Alexandr-Filatov/KAMAZ_MCU_PCB/Отчетность/Финальный комплект/МПСТ.76721.687263.02.М - Спецификация на плату управления.pdf

Форм.
Зона
Поз.
Обозначение | Наименование

Кол.
Примеч.

Документация

МПСТ.76721.687263.02.М СБ | Сборочный чертеж | 1 | А3х3

Материалы

1 | Стеклотекстолит

фольгированный

FR4 Tg150 35/35-0,3 | 2
2 | | Стеклоткань
препрег FR4 2116 0,115 | 4
3 | | Стеклоткань
препрег FR4 1080 0,076 | 2
4 | | Защитная паяльная маска
Elpemer SD 2467 SM-LDI | 2

## МПСТ.76721.687263.01.М

Изм | Лист | № докум. | Подп. | Дата
Разраб. | Филатов

### Плата управления

Лит. | Лист | Листов
Пров. | Нестеров | 1

### Московский Политех

Н.контр. | Саяхов
Утв. | Келлер
