Alexandr-Filatov/KAMAZ_MCU_PCB/Отчетность/Финальный комплект/МПСТ.76721.758764.02.М - Спецификация на узел управления.pdf

Форм.
Зона
Поз.
Обозначение | Наименование

Кол.
Примеч.

Документация

А3 | МПСТ.76721.758764.02.М СБ | Сборочный чертеж
А4 | МПСТ.76721.758764.02.М Э3 | Схема электрическая

принципиальная

А4 | МПСТ.76721.758764.02.М ПЭ3 | Перечень элементов

Сборочные единицы

А4 | 1 | МПСТ.76721.687263.02.М | Плата силовая | 1

Прочие изделия

2 | Конденсаторы

GRM188R61E106M-25В-

10 мк-20% | 3
3 | Конденсаторы

GRM188R61E475KE11D-25В-

4,7 мкФ-10% | 3
4 | Конденсаторы

GRM188R71C104KA01D-16В-

100 нФ-10% | 20

## МПСТ.76721.758764.02.М

Изм | Лист | № докум. | Подп. | Дата
Разраб. | Филатов

### Узел управления

Лит. | Лист | Листов
Пров. | Нестеров | 1 | 5
Московский
Политех Н.контр. | Саяхов
Утв. | Келлер

5 | Конденсаторы

GRM1885C1H560J-50В-

56 пФ-5% | 9
6 | Конденсатор

GRM188R61E475KE11D-25В-

4,7 мкФ-10% | 1
7 | Конденсаторы

GRM188R71E105KA12D-25В-

1 мкФ-10% | 9
8 | Конденсаторы

GRM188R61A225K-10В-

2,2 мкФ-10% | 2
9 | Конденсаторы

GRM32ER71H106K-50В-

10 мкФ-10% | 6
10 | Конденсаторы

GRM31CR71E106KA12L-25В-

10 мкФ-10% | 2
11 | | Резисторы
RC0603-0,1-10 кОм-1% | 9
12 | Резисторы

6

## МПСТ.76721.758764.02.М

Лист

Изм | Лист | № докум. | Подп. | Дата

13 | | Резистор
RC0603-0,1-1,3 кОм-1% | 1
14 | | Резисторы
RC0603-0,1-1 кОм-1% | 6
15 | | Резисторы
RC0603-0,1-120 Ом-1% | 5
16 | | Резисторы
RC0603-0,1-0 Ом-1% | 8
17 | | Резисторы
RC0603-0,1-1,5 кОм-1% | 2
18 | | Резистор
RC0805-0,125-120 Ом-1% | 1
19 | | Резистор
RC0603-0,1-13 кОм-1% | 1
20 | | Микросхемы CAN
SIT65HVD232DR | 2
21 | | Драйвера MOSFET
IR2184S | 3
22 | | Компаратор
LMV7239M5 | 1

23 | | Дифференциальный
усилитель INA282AID | 1
24 | | Тактовый генератор
ASEMB-10.000MHZ-LC-T | 1
25 | | Микроконтроллер
APM32F407VGT6 | 1
26 | | Микросхема RS-485
ADM3491ARZ | 1
27 | | DC-DC преобразователь
LM2594HVM-12 | 1
28 | | Операционный усилитель
LMV321IDBVR | 1
29 | | DC-DC преобразователь
LM2594HVM-3.3 | 1
30 | Сегнетоэлектрическое

ОЗУ

FM25W256-GTR | 1
31 | Диоды BAS321 | 8
32 | | Устройство защиты
RS-484 PSM712 | 1

33 | Диод Шоттки MBRA320 | 2
34 | | Устройство защиты
CAN шины PESD2CAN | 2
35 | | Ферритовая бусина
BLM18KG102SH1D | 1
36 | | Разъем PicoBlade
SCT1251WR-2P | 2
37 | Штыри на плату PLD-14 | 1
38 | | Разъем PicoBlade
SCT1251WR-5P | 1
39 | | Разъем PicoBlade
SCT1251WR-6P | 1
40 | Вилка штыревая PLD-20 | 1
41 | | Индуктивность 22мкГн-
20% LQH66SN220M | 1
42 | | Индуктивность 33мкГн-
20% LQH66SN220M | 1
Изм | Лист | №докум. | Подп. | Дата
