Alexandr-Filatov/KAMAZ_MCU_PCB/Отчетность/Финальный комплект/МПСТ.76721.758764.02.М ПЭ3 - Узел управления перечень элементов.pdf

Подп. и дата Инв. № дубл. Взам. инв. № Подп. и дата Инв. № подл.

0000 | Копировал | Формат А4

МПСТ.76721.758764.02

Перв. примен. Справ. №

## МПСТ.76721.758764.02.М ПЭ3

Изм. | Лист | № докум. | Подп. | Дата
| | Филатов Сизякин Шевырев Саяхов Келлер

Разраб.
Пров.
Нач. сект.
Н. контр.
Утв. | Перечень элементов

Узел управления

Листов
4

Лист

Московский Политех

Лит.

Поз.
обозначение
Наименование | Кол. | Примечание

Конденсаторы

C1…C3 | GRM188R61E106M-25В-10 мкФ-20% | 3
С4…С6 | GRM188R61E475KE11D-25В-4,7 мкФ-10% | 3
C7,С8 | GRM188R71C104KA01D-16В-100 нФ-10% | 2
С9,С10 | GRM1885C1H560J-50В-56 пФ-5% | 2
С11 | GRM188R61E475KE11D-25В-4,7 мкФ-10% | 1
С12 | GRM188R71C104KA01D-16В-100 нФ-10% | 1
С13 | GRM188R71E105KA12D-25В-1 мкФ-10% | 1
С14 | GRM188R71C104KA01D-16В-100 нФ-10% | 1
С15 | GRM188R71E105KA12D-25В-1 мкФ-10% | 1
С16…С24 | GRM188R71C104KA01D-16В-100 нФ-10% | 9
С25 | GRM188R71E105KA12D-25В-1 мкФ-10% | 1
С26…С29 | GRM188R71C104KA01D-16В-100 нФ-10% | 4
С30,С31 | GRM188R61A225K-10В-2,2 мкФ-10% | 2
С32,С33 | GRM188R71C104KA01D-16В-100 нФ-10% | 2
С34…С36 | GRM32ER71H106K-50В-10 мкФ-10% | 3
С37 | GRM188R71C104KA01D-16В-100 нФ-10% | 1
С38 | GRM1885C1H560J-50В-56 пФ-5% | 1
С39…С41 | GRM32ER71H106K-50В-10 мкФ-10% | 3
С42,С43 | GRM31CR71E106KA12L-25В-10 мкФ-10% | 2
С44…С47 | GRM1885C1H560J-50В-56 пФ-5% | 4
С48…С51 | GRM188R71E105KA12D-25В-1 мкФ-10% | 4
С52,С53 | GRM1885C1H560J-50В-56 пФ-5% | 2

Подп. и дата Инв. № дубл. Взам. инв. № Подп. и дата Инв. № подл.

## МПСТ.76721.758764.02.М ПЭ3

Лист

Изм. | Лист | № докум. | Подп. | Дата | 2
С54,С55 | GRM188R71E105KA12D-25В-1 мкФ-10% | 2
| Резисторы
R1…R6 | RC0603-0,1-10 кОм-1% | 6
R7…R12 | RC0603-0,1-1 кОм-1% | 6
R13 | RC0603-0,1-1,3 кОм-1% | 1
R14 | RC0603-0,1-1 кОм-1% | 1
R15,R16 | RC0603-0,1-120 Ом-1% | 2
R17…R19 | RC0603-0,1-10 кОм-1% | 3
R20 | RC0603-0,1-0 Ом-1% | 1
R21,R22 | RC0603-0,1-1 кОм-1% | 2
R23 | RC0603-0,1-0 Ом-1% | 1
R24 | RC0603-0,1-1 кОм-1% | 1
R25 | RC0603-0,1-1,5 кОм-1% | 1
R26…
R30 | RC0603-0,1-0 Ом-1% | 5
R31 | RC0805-0,125-120 Ом-1% | 1
R32 | RC0603-0,1-13 кОм-1% | 1
R33 | RC0603-0,1-120 Ом-1% | 1
R34 | RC0603-0,1-1 кОм-1% | 1
R35,R36 | RC0603-0,1-120 Ом-1% | 2
R37 | RC0603-0,1-1 кОм-1% | 1
R38 | RC0603-0,1-1,5 кОм-1% | 1
R39 | RC0603-0,1-0 Ом-1% | 1
| Микросхемы
D9,D10 | SIT65HVD232DR | 2
U1…U3 | IR2184S | 3

Подп. и дата Инв. № дубл. Взам. инв. № Подп. и дата Инв. № подл.

Изм. | Лист | № докум. | Подп. | Дата | 3
U4 | LMV7239M5/NOPB | 1
U5 | INA282AID | 1
U6 | ASEMB-10.000MHZ-LC-T | 1
U7 | APM32F407VGT6 | 1
U8 | ADM3491ARZ | 1
U9 | LM2594HVM-12 | 1
U10 | LMV321IDBVR | 1
U11 | LM2594HVM-3.3 | 1
U12 | FM25W256-GTR | 1
D1…D3 | Диод BAS321 | 3
D4,D5 | Диод BAS321 | 2
D6 | Устройство защиты RS-484 PSM712 | 1
D7,D8 | Диод Шоттки MBRA320 | 2
D11, D12 | Устройство защиты CAN шины PESD2CAN | 2
D13 | Диод BAS321 | 1
D14,D15 | Диод BAS321 | 2
FB1 | Ферритовая бусина BLM18KG102SH1D | 1
J4 | Разъем PicoBlade розетка на плату
| SCT1251WR-2P | 1
J5 | Штыри на плату PLD-14 | 1

Подп. и дата Инв. № дубл. Взам. инв. № Подп. и дата Инв. № подл.

Изм. | Лист | № докум. | Подп. | Дата | 4
J6 | Разъем PicoBlade розетка на плату
| SCT1251WR-2P | 1
J7 | Разъем PicoBlade розетка на плату
| SCT1251WR-5P | 1
J8 | Вилка штыревая PLD-20 | 1
J9 | Разъем PicoBlade розетка на плату
| SCT1251WR-6P | 1
L1 | Индуктивность 22мкГн-20% LQH66SN220M | 1
L2 | Индуктивность 33мкГн-20% LQH66SN220M | 1
