Alexandr-Filatov/KAMAZ_MCU_PCB/3D models/Плата управления.step

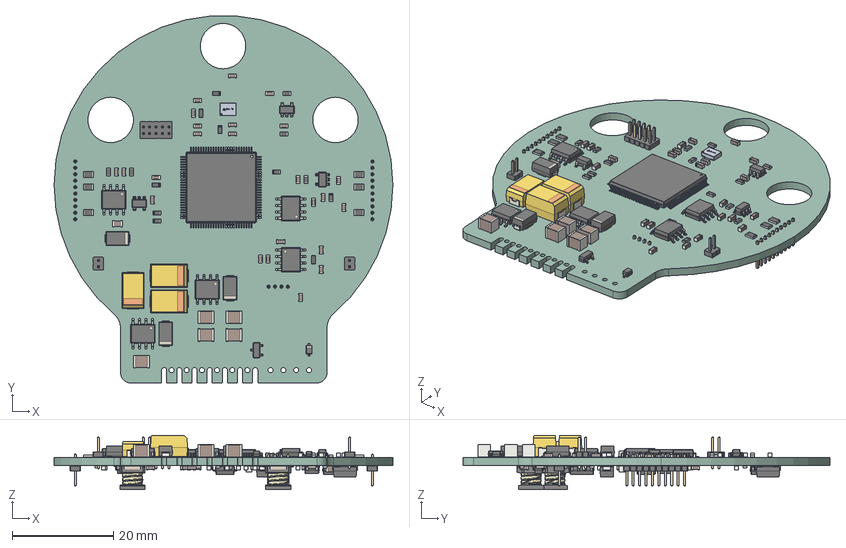
[picture p1: CAD file, 2024-12-02]
3D models/Плата управления.step
67.0 x 72.6 x 10.7 mm
R_0805_2012Metric x 6
ASEMB-50.000MHZ-LC-T
D_SOD_323
R_0603_1608Metric x 25
L_0603_1608Metric
SOT_23_5 x 5
C_0603_1608Metric x 46
CP_EIA_7343_43_Kemet_X x 2
D_SMA x 5
SOT_23
SOIC_8_39x49mm_P127mm x 8
C_1210_3225Metric x 5
C_0805_2012Metric x 3
PinHeader_2x05_P127mm_Vertical
PinHeader_1x02_P127mm_Vertical x 2
CP_EIA_7343_31_Kemet_D
LQFP_100_14x14mm_P05mm
LQH55DN220M03L x 2
PinHeader_1x10_P127mm_Vertical x 2
PinHeader_1x04_P127mm_Vertical
行恍把邪 研垦邪胁谢械薪懈裚PCB
