Alexandr-Filatov/KAMAZ_MCU_PCB/3D models/LQH55DN103M03L.stp

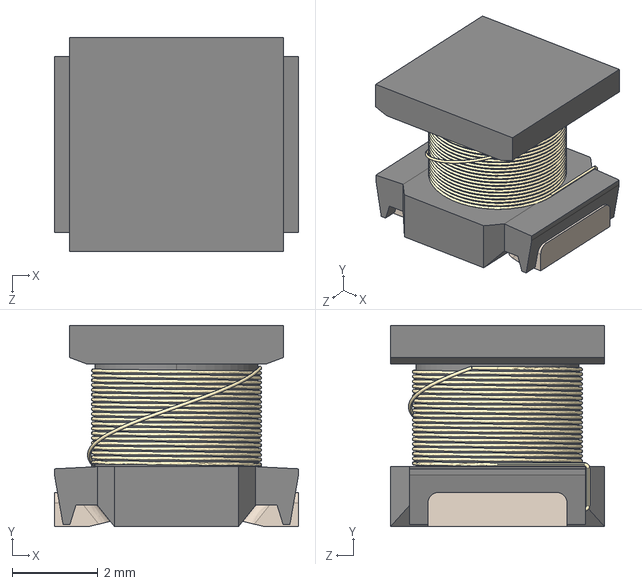
[picture p3: CAD file, 2024-08-01]
3D models/LQH55DN103M03L.stp
5.70 x 4.70 x 5.00 mm
