Alexandr-Filatov/KAMAZ_MCU_PCB/Плата управления/Чертежи/Плата управления-Edge_Cuts.dxf

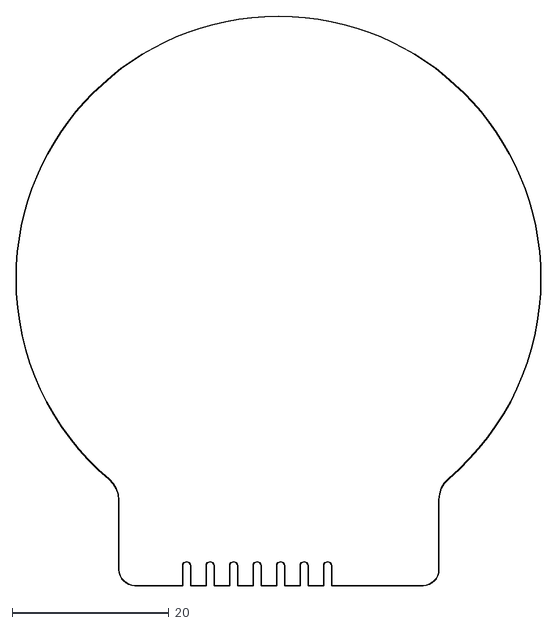
[picture p5: CAD file, 2024-12-02]
Плата управления/Чертежи/Плата управления-Edge_Cuts.dxf
67.0 x 72.7
