Alexandr-Filatov/KAMAZ_MCU_PCB/Плата управления/Чертежи/Плата управления-drl_map.dxf

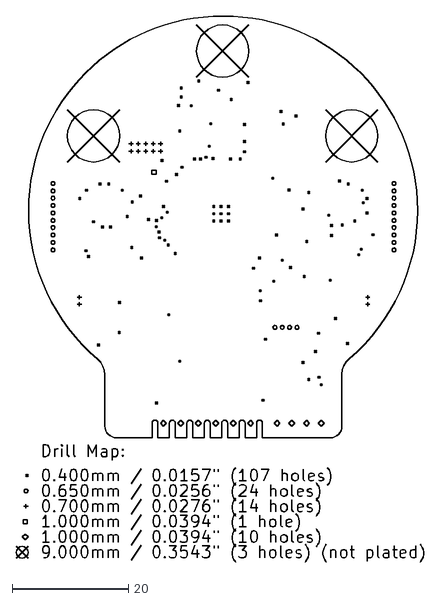
[picture p6: CAD file, 2024-12-02]
Плата управления/Чертежи/Плата управления-drl_map.dxf
70.1 x 94.0
