Alexandr-Filatov/KAMAZ_MCU_PCB/3D models/ASEMB-10.000MHZ-XY-T.stp

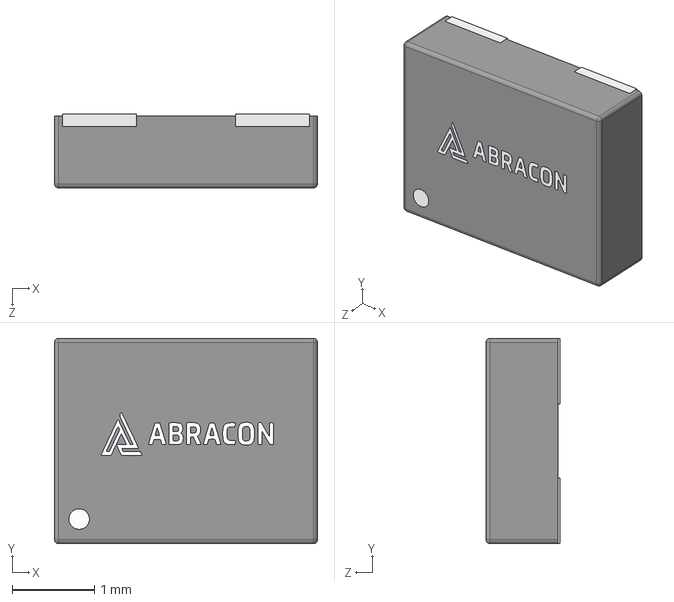
[picture p7: CAD file, 2023-11-29]
3D models/ASEMB-10.000MHZ-XY-T.stp
3.20 x 2.50 x 0.901 mm
ASEMB-50.000MHZ-LC-T
Abracon New Logo
