Alexandr-Filatov/KAMAZ_MCU_PCB/Плата управления/Чертежи/Плата управления-In3_Cu.dxf

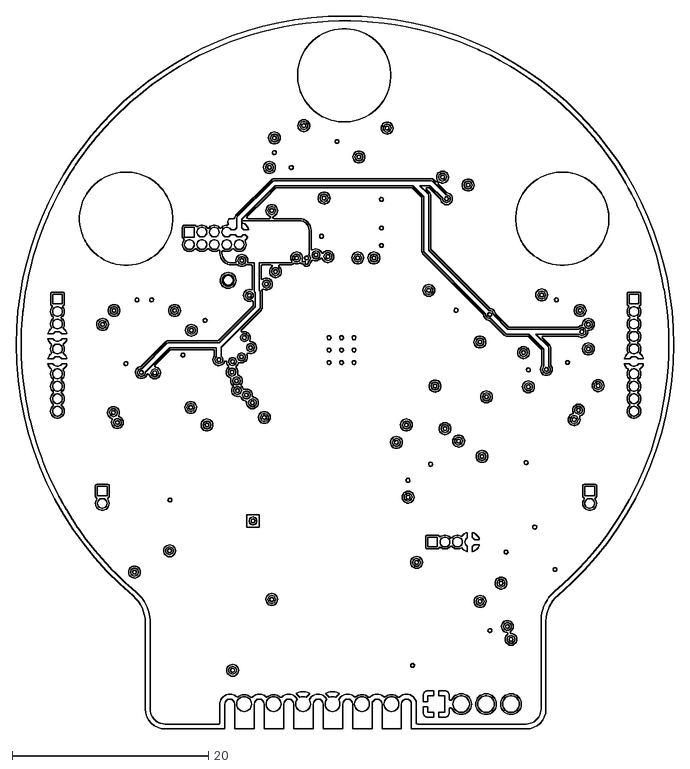
[picture p8: CAD file, 2024-12-02]
Плата управления/Чертежи/Плата управления-In3_Cu.dxf
67.0 x 72.7
