Alexandr-Filatov/KAMAZ_MCU_PCB/3D models/LQH66SN103M03K.stp

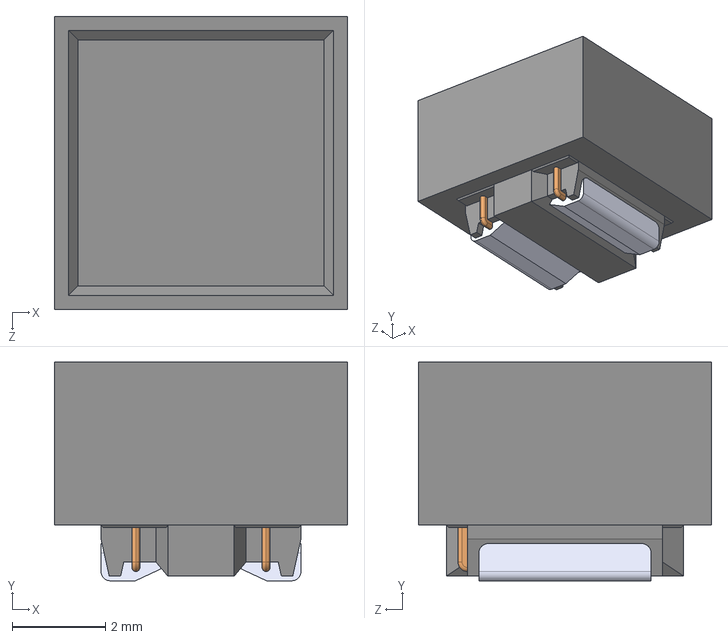
[picture p12: CAD file, 2023-11-18]
3D models/LQH66SN103M03K.stp
6.30 x 4.70 x 6.30 mm
