Alexandr-Filatov/KAMAZ_MCU_PCB/3D models/TPSM365R6FRDNR.stp

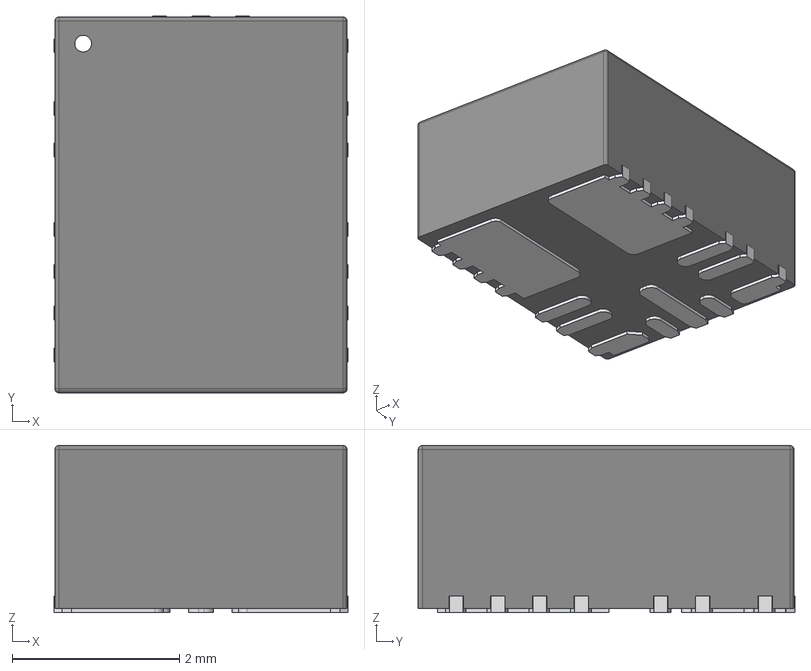
[picture p13: CAD file, 2023-11-18]
3D models/TPSM365R6FRDNR.stp
3.52 x 4.51 x 2.00 mm
