Alexandr-Filatov/KAMAZ_MCU_PCB/3D models/IHLP2525.step

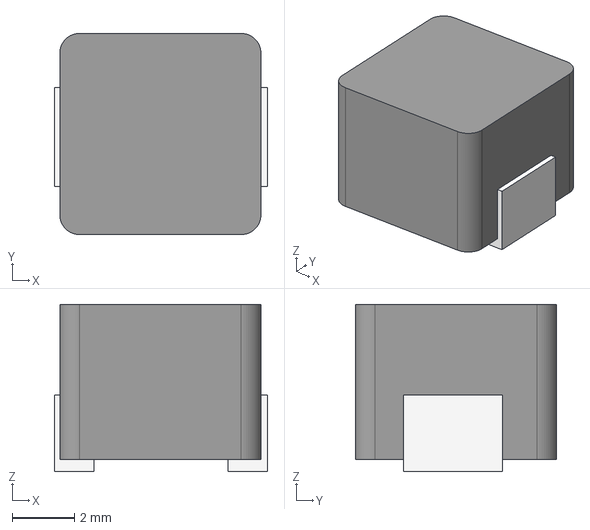
[picture p14: CAD file, 2023-11-18]
3D models/IHLP2525.step
6.86 x 6.48 x 5.39 mm
