Alexandr-Filatov/KAMAZ_MCU_PCB/(list of files, cad)

Other CAD files:
Отчетность/Плата управления чертежи/Сборочный на пп лист 2 02.dwg
Отчетность/Узел управления чертежи/Сборочный чертёж 02.dwg
Отчетность/Плата управления чертежи/Сборочный чертёж на плату 02.dwg
Отчетность/Плата управления чертежи/Сборочный на пп лист 3 02.dwg
3D models/User Library-sop8_model.STEP
3D models/530480610.stp
3D models/530481010.stp
3D models/532610271.STEP
3D models/532610371.STEP
3D models/532610471.STEP
3D models/532610571.STEP
3D models/532610671.STEP
3D models/532610771.STEP
3D models/532610871.STEP
3D models/532610971.STEP
3D models/532611071.STEP
3D models/532611171.STEP
3D models/532611271.STEP
3D models/532611371.STEP
3D models/532611471.STEP
3D models/532611571.STEP
3D models/532611771.STEP
3D models/70372589.stp
3D models/70372976.stp
Плата управления/Чертежи/Плата управления-B_Mask.dxf
Плата управления/Чертежи/Плата управления-B_Silkscreen.dxf
Плата управления/Чертежи/Плата управления-F_Mask.dxf
Плата управления/Чертежи/Плата управления-F_Silkscreen.dxf
