Alexandr-Filatov/KAMAZ_MCU_PCB/Отчетность/Финальный комплект/МПСТ.76721.687263.02.М СБ - Плата управления.pdf

1,5 68,53

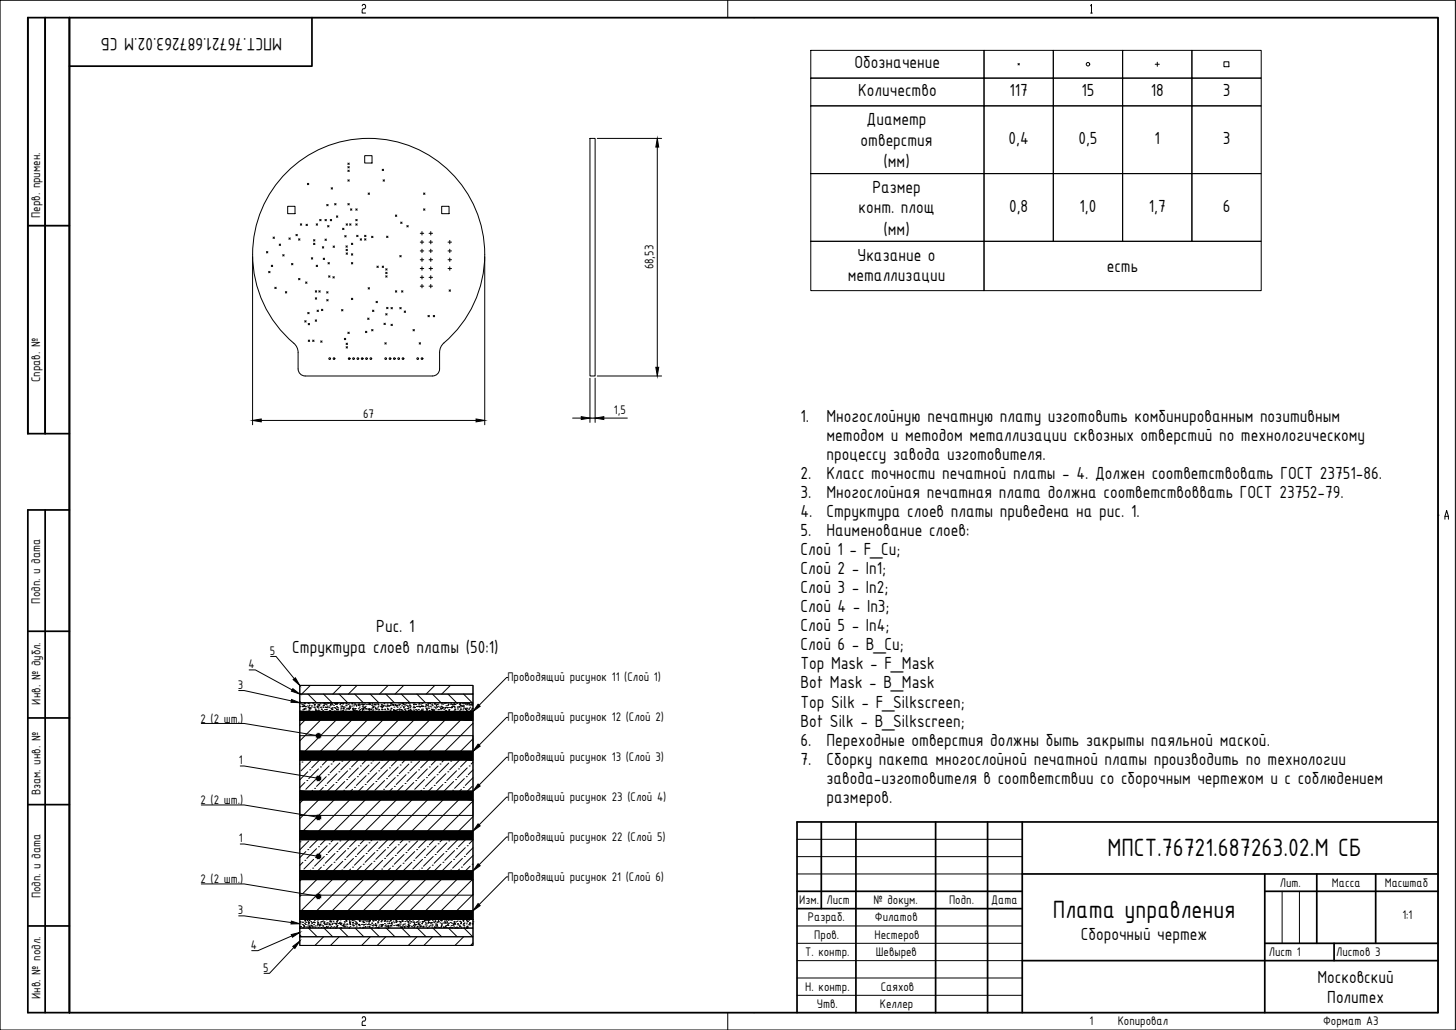
[picture p16: page 1]
Обозначение; Количество; Диаметр отверстия (мм); Размер конт. площ (мм); Указание о металлизации; есть; Рис. 1; Копировал; Формат А3; Разраб. Т. контр. Пров. Н. контр. Утв.; Лит.; Масса; Масштаб; Лист 1; Листов 3; Келлер; Плата управления; Сборочный чертеж; МПСТ.76721.687263.02.М СБ; Московский Политех

Структура слоев платы (50:1) Справ. № Перв. примен. Подп. и дата Инв. № дубл. Взам. инв. № Подп. и дата Инв. № подл.

1. Многослойную печатную плату изготовить комбинированным позитивным
методом и методом металлизации сквозных отверстий по технологическому
процессу завода изготовителя. 2. Класс точности печатной платы - 4. Должен соответствовать ГОСТ 23751-86.

3. Многослойная печатная плата должна соответствоввать ГОСТ 23752-79.
4. Структура слоев платы приведена на рис. 1.
5. Наименование слоев:
Слой 1 - F_Cu;
Слой 2 - In1;
Слой 3 - In2;
Слой 4 - In3;
Слой 5 - In4;
Слой 6 - B_Cu;
Top Mask - F_Mask
Bot Mask - B_Mask
Top Silk - F_Silkscreen;
Bot Silk - B_Silkscreen;
6. Переходные отверстия должны быть закрыты паяльной маской. 7. Сборку пакета многослойной печатной платы производить по технологии

Проводящий рисунок 11 (Слой 1)

Проводящий рисунок 12 (Слой 2)

Проводящий рисунок 13 (Слой 3)

завода-изготовителя в соответствии со сборочным чертежом и с соблюдением
размеров.

Проводящий рисунок 23 (Слой 4)

Проводящий рисунок 22 (Слой 5)

Проводящий рисунок 21 (Слой 6)

Изм. | Лист | № докум. | Подп. | Дата

Филатов
Нестеров
Шевырев

Саяхов

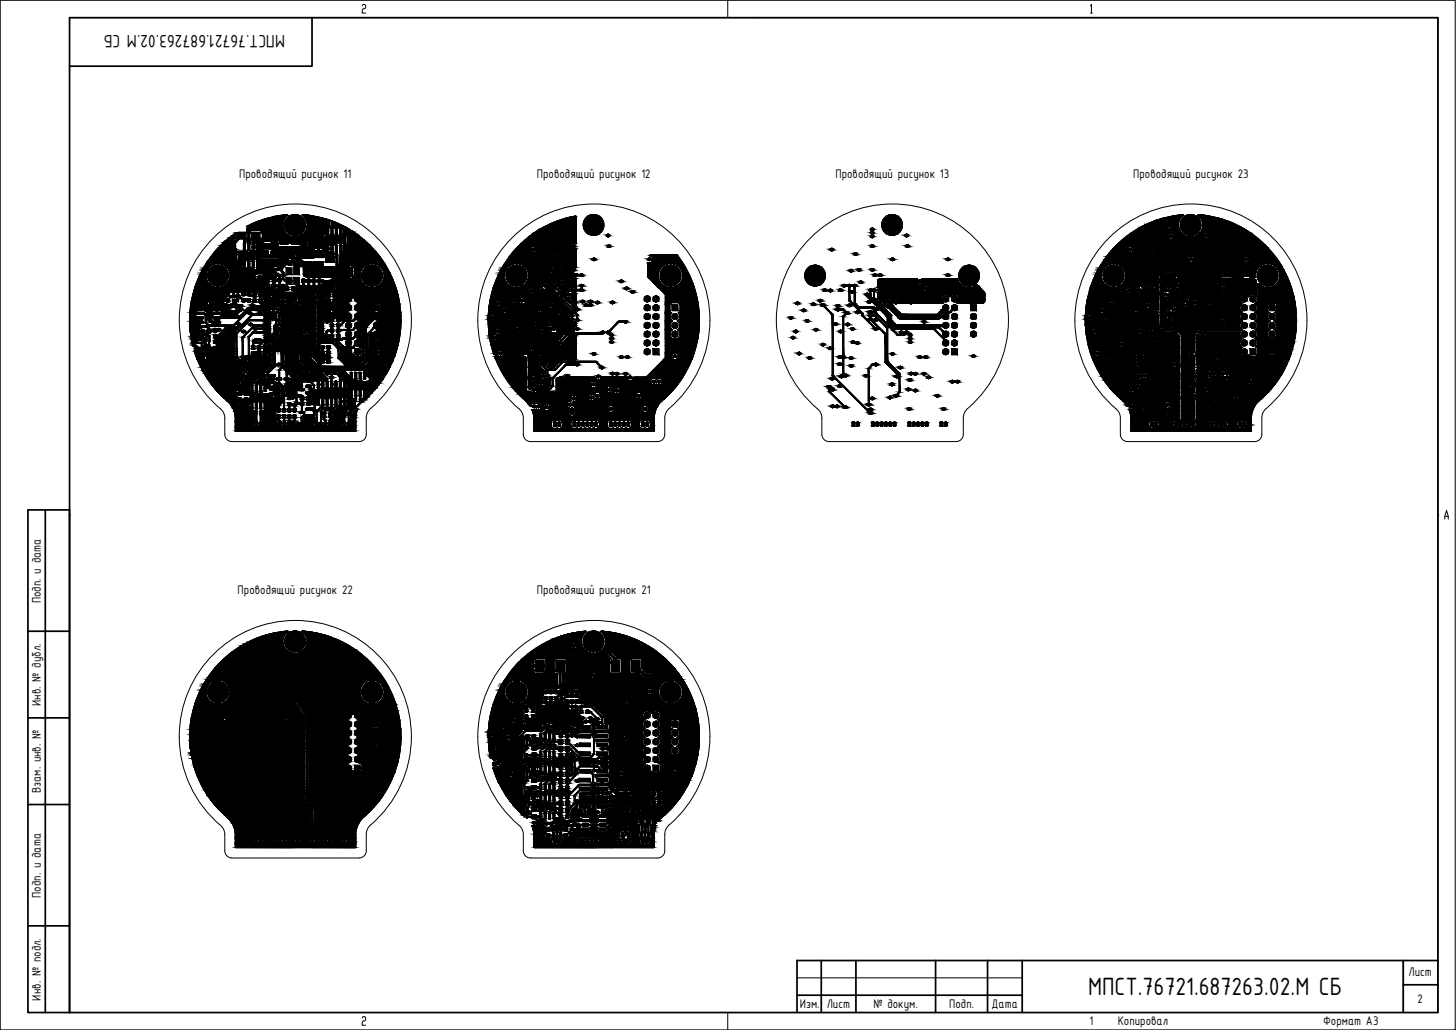
[picture p17: page 2]
Проводящий рисунок 11; Проводящий рисунок 12; Проводящий рисунок 13; Проводящий рисунок 23; Проводящий рисунок 22; Проводящий рисунок 21; № докум.; Подп.; Дата Инв. № подл. Подп. и дата Взам. инв. № Инв. № дубл. Подп. и дата; Копировал; Лист; Формат А3; Изм.; МПСТ.76721.687263.02.М СБ

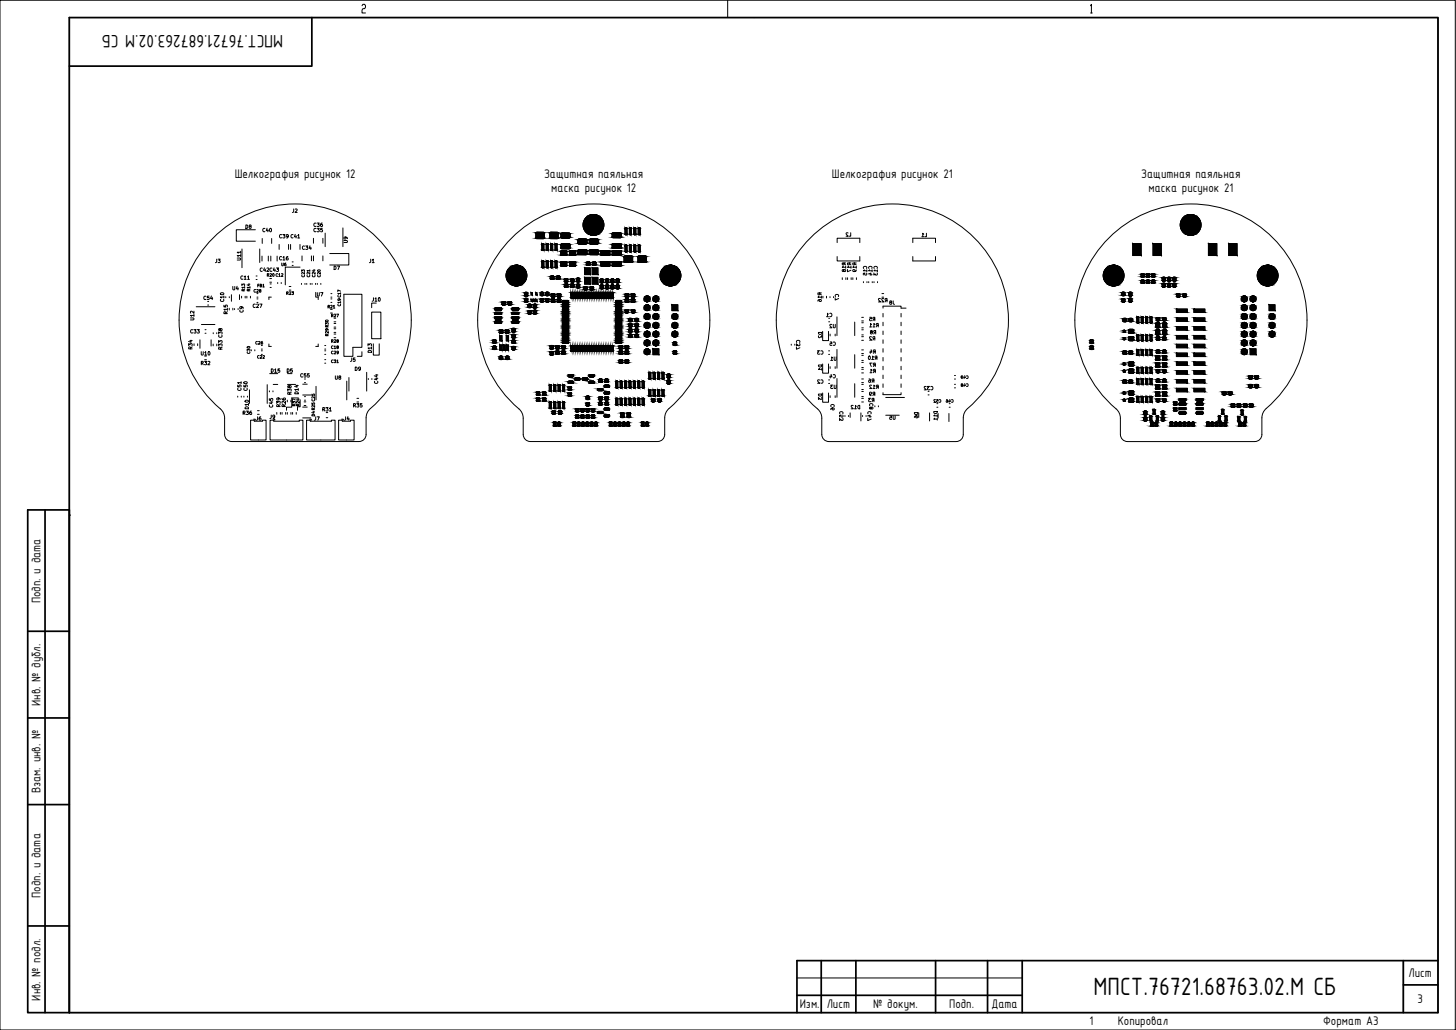
[picture p18: page 3]
Шелкография рисунок 12; Защитная паяльная; маска рисунок 12; Шелкография рисунок 21; маска рисунок 21; № докум.; Подп.; Дата Инв. № подл. Подп. и дата Взам. инв. № Инв. № дубл. Подп. и дата; Копировал; Лист; Формат А3; Изм.; МПСТ.76721.68763.02.М СБ
