Alexandr-Filatov/KAMAZ_MCU_PCB/Отчетность/Финальный комплект/МПСТ.76721.758764.02.М СБ - Узел управления.pdf

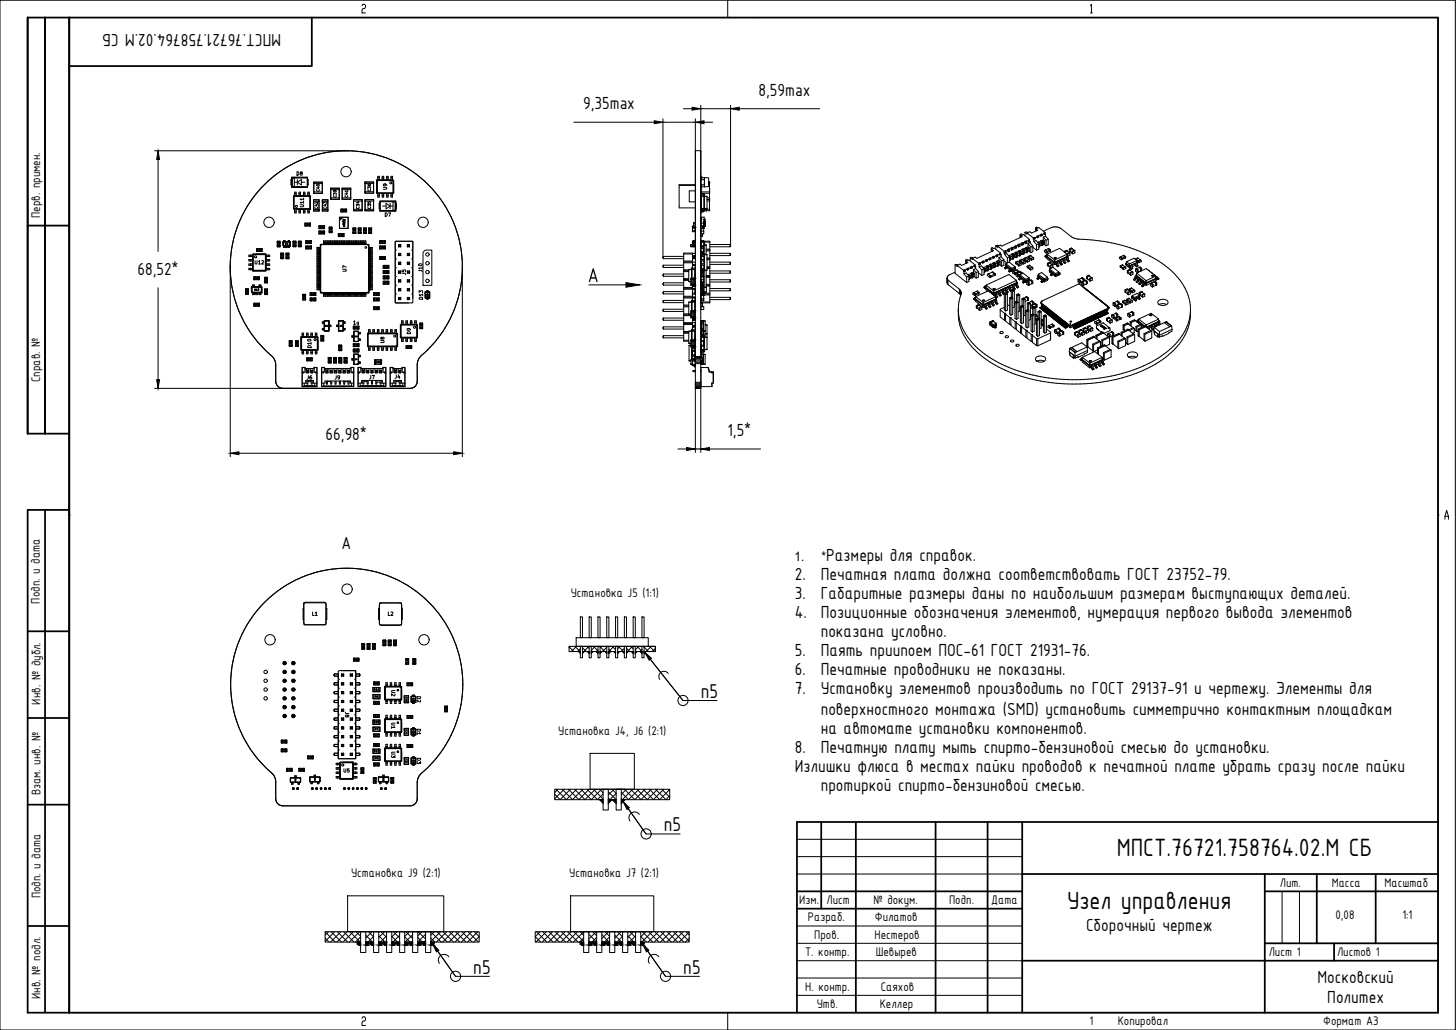
[picture p19: page 1]
Копировал; Формат А3; Лист 1; Листов 1; Узел управления; Сборочный чертеж; МПСТ.76721.758764.02.М СБ; Установка J5 (1:1); Установка J4, J6 (2:1); Установка J7 (2:1); Установка J9 (2:1)

Справ. № Перв. примен. Подп. и дата Инв. № дубл. Взам. инв. № Подп. и дата Инв. № подл.

1. *Размеры для справок.
2. Печатная плата должна соответствовать ГОСТ 23752-79.
3. Габаритные размеры даны по наибольшим размерам выступающих деталей.
4. Позиционные обозначения элементов, нумерация первого вывода элементов
показана условно.
5. Паять приипоем ПОС-61 ГОСТ 21931-76.
6. Печатные проводники не показаны.
7. Установку элементов производить по ГОСТ 29137-91 и чертежу. Элементы для
поверхностного монтажа (SMD) установить симметрично контактным площадкам
на автомате установки компонентов.
8. Печатную плату мыть спирто-бензиновой смесью до установки.
Излишки флюса в местах пайки проводов к печатной плате убрать сразу после пайки
протиркой спирто-бензиновой смесью.

Изм. | Лист | № докум. | Подп. | Дата
Разраб. Т. контр. Пров. Н. контр. Утв. | | Шевырев

Филатов
Нестеров

Саяхов
