Alexandr-Filatov/KAMAZ_MCU_PCB/Плата управления/Плата управления.kicad_pcb

## KiCad design Плата управления/Плата управления.kicad_pcb (2024-12-02)

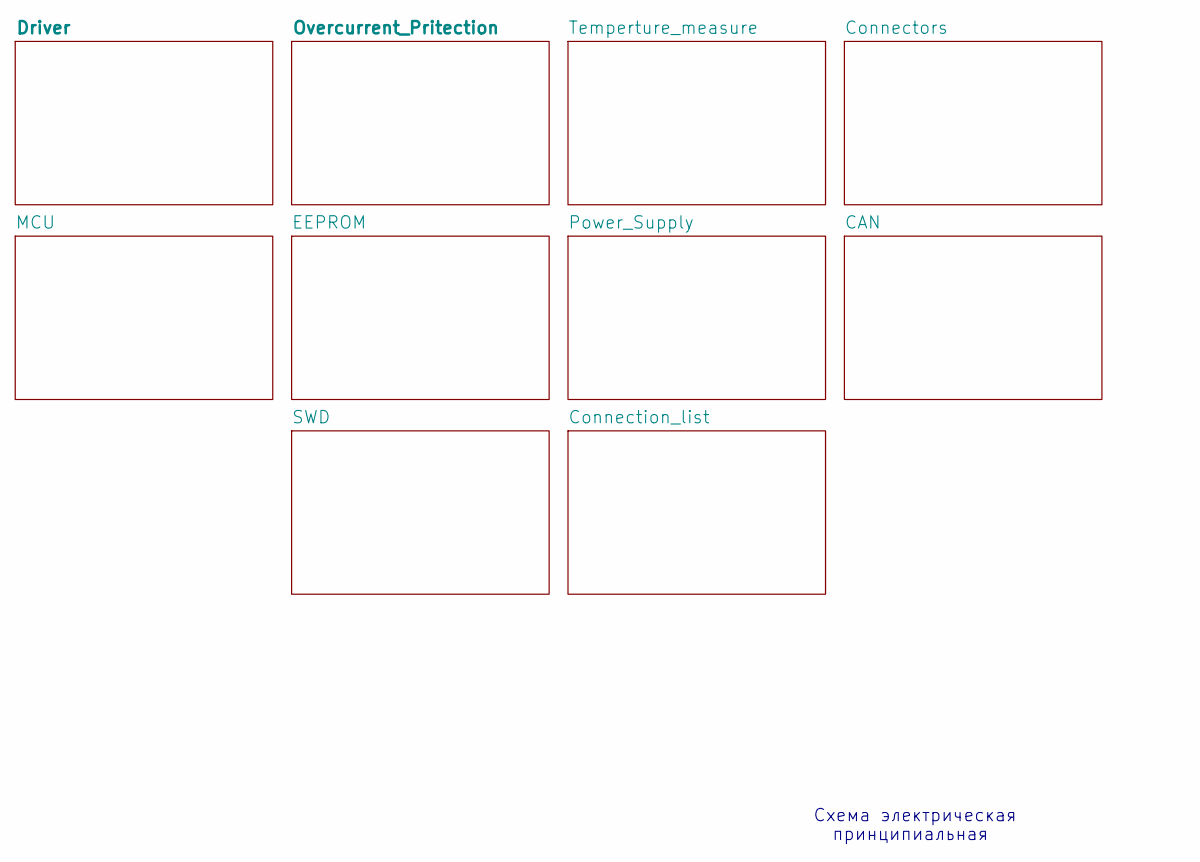
[picture p20: schematic Плата управления.kicad_sch, Узел управления]

Notes on the sheet:
принципиальная
Схема электрическая

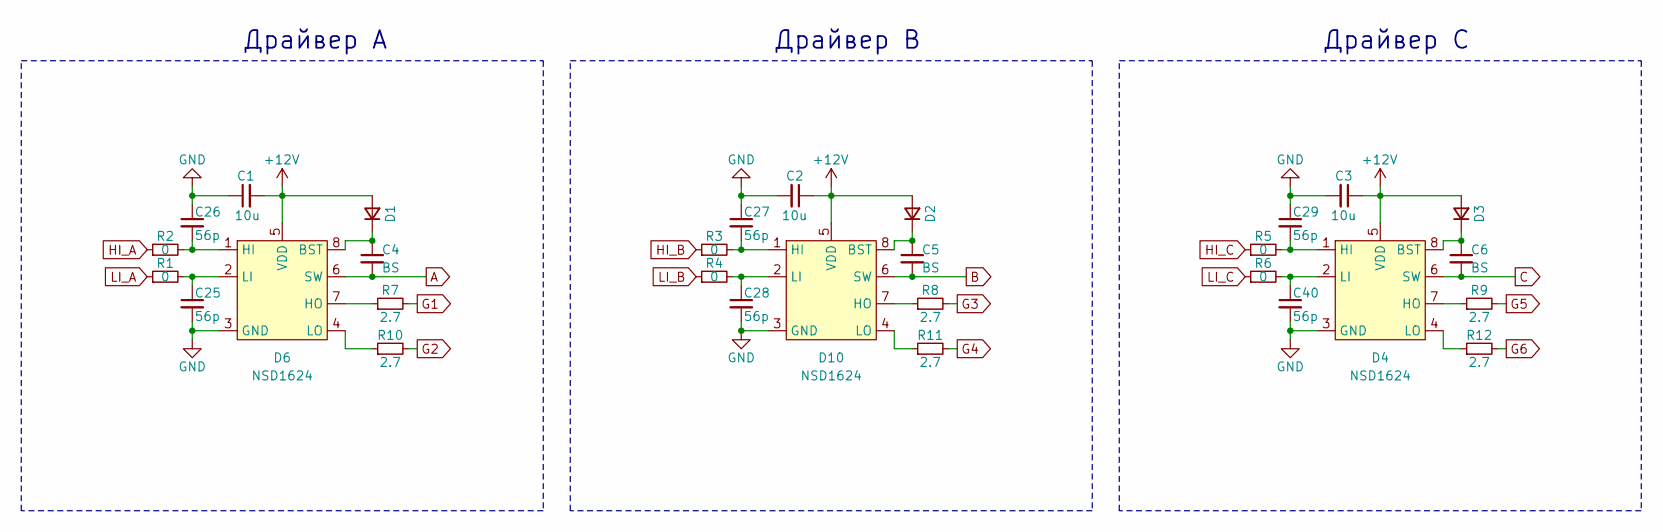
[picture p21: schematic Driver.kicad_sch]

Parts:
C1, C2, C3: 10u; C_0603_1608Metric_Pad1.08x0.95mm_HandSolder
C4, C5, C6: BS; C_0805_2012Metric_Pad1.18x1.45mm_HandSolder
C25, C26, C27, C28, C29, C40: 56p; C_0603_1608Metric_Pad1.08x0.95mm_HandSolder
D1, D2, D3: D_Small; D_SMA
D4, D6, D10: NSD1624; SOIC-8_3.9x4.9mm_P1.27mm
R1, R2, R3, R4, R5, R6: 0; R_0603_1608Metric_Pad0.98x0.95mm_HandSolder
R7, R8, R9, R10, R11, R12: 2.7; R_0805_2012Metric_Pad1.20x1.40mm_HandSolder

Connections:
+12V: C1.2, C2.1, C3.1, D1.2 (A), D2.2 (A), D3.2 (A), D4.5 (VDD), D6.5 (VDD), D10.5 (VDD); also elsewhere on the board
A: C4.2, D6.6 (SW); also elsewhere on the board
B: C5.2, D10.6 (SW); also elsewhere on the board
C: C6.2, D4.6 (SW); also elsewhere on the board
G1: R7.2; also elsewhere on the board
G2: R10.2; also elsewhere on the board
G3: R8.2; also elsewhere on the board
G4: R11.2; also elsewhere on the board
G5: R9.2; also elsewhere on the board
G6: R12.2; also elsewhere on the board
GND: C1.1, C2.2, C3.2, C25.2, C26.1, C27.1, C28.2, C29.1, C40.2, D4.3 (GND), D6.3 (GND), D10.3 (GND); also elsewhere on the board
HI_A: R2.1; also elsewhere on the board
HI_B: R3.1; also elsewhere on the board
HI_C: R5.1; also elsewhere on the board
LI_A: R1.1; also elsewhere on the board
LI_B: R4.1; also elsewhere on the board
LI_C: R6.1; also elsewhere on the board
unnamed: C4.1, D1.1 (K), D6.8 (BST)
unnamed: C6.1, D3.1 (K), D4.8 (BST)
unnamed: C29.2, D4.1 (HI), R5.2
unnamed: D4.7 (HO), R9.1
unnamed: C40.1, D4.2 (LI), R6.2
unnamed: D4.4 (LO), R12.1
unnamed: C26.2, D6.1 (HI), R2.2
unnamed: D6.7 (HO), R7.1
unnamed: C25.1, D6.2 (LI), R1.2
unnamed: D6.4 (LO), R10.1
unnamed: C5.1, D2.1 (K), D10.8 (BST)
unnamed: C27.2, D10.1 (HI), R3.2
unnamed: D10.7 (HO), R8.1
unnamed: C28.1, D10.2 (LI), R4.2
unnamed: D10.4 (LO), R11.1

Notes on the sheet:
Драйвер С
Драйвер А
Драйвер В

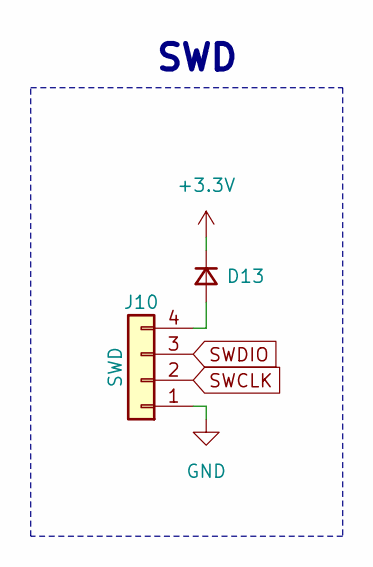
[picture p22: schematic SWD.kicad_sch]

Parts:
D13: D_Small; D_SOD-323_HandSoldering
J10: SWD; PinHeader_1x04_P2.54mm_Vertical

Connections:
+3.3V: D13.1 (K); also elsewhere on the board
GND: J10.1; also elsewhere on the board
unnamed: D13.2 (A), J10.4
SWCLK: J10.2; also elsewhere on the board
SWDIO: J10.3; also elsewhere on the board

Notes on the sheet:
SWD

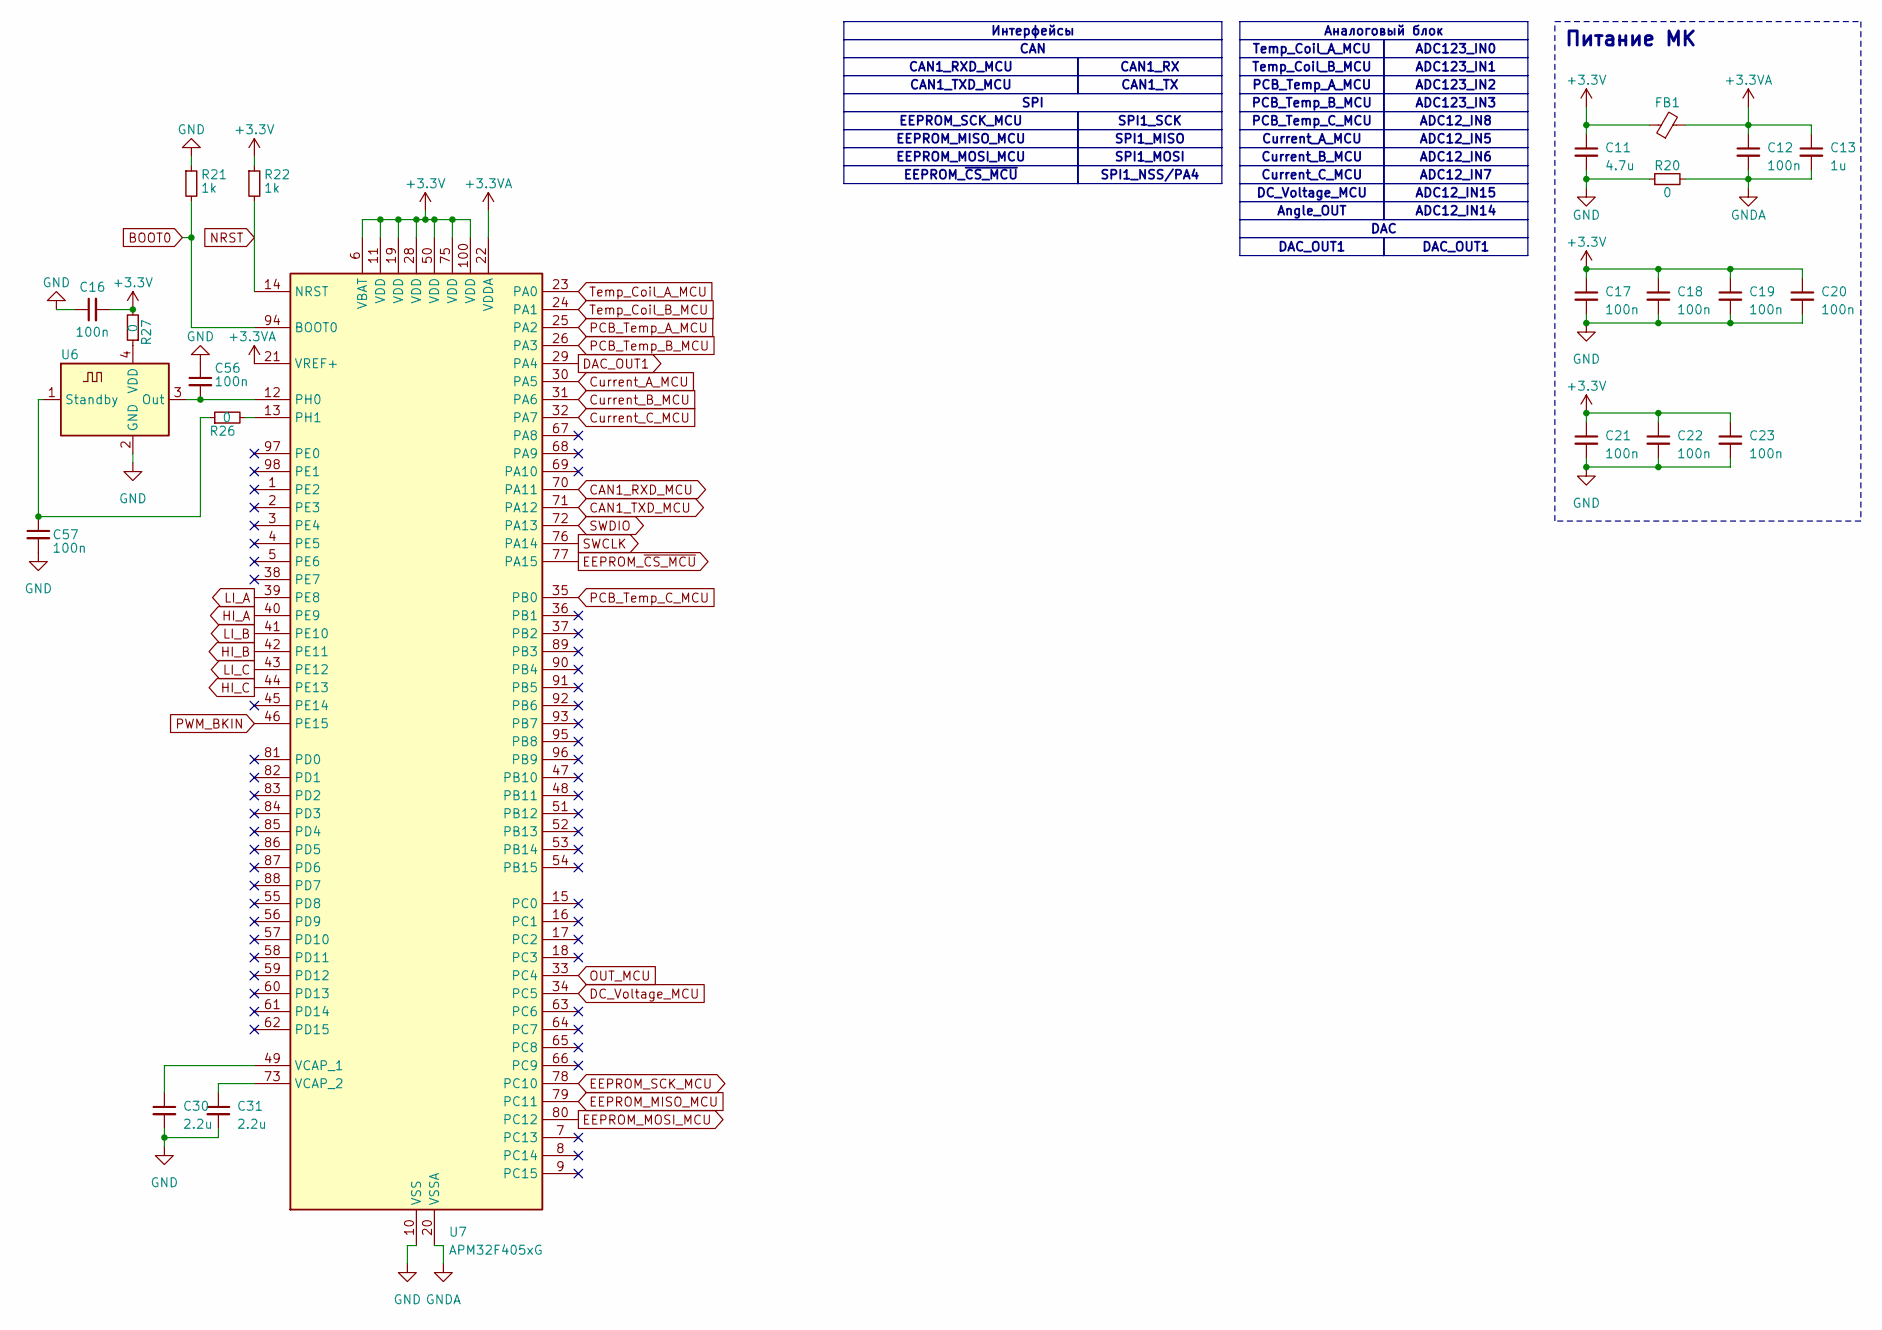
[picture p23: schematic MCU.kicad_sch]

Parts:
C11: 4.7u; C_0603_1608Metric_Pad1.08x0.95mm_HandSolder
C12, C16, C17, C18, C19, C20, C21, C22, C23, C56, C57: 100n; C_0603_1608Metric_Pad1.08x0.95mm_HandSolder
C13: 1u; C_0603_1608Metric_Pad1.08x0.95mm_HandSolder
C30, C31: 2.2u; C_0603_1608Metric_Pad1.08x0.95mm_HandSolder
FB1: BLM18KG102SH1D; L_0603_1608Metric_Pad1.05x0.95mm_HandSolder
R20, R26, R27: 0; R_0603_1608Metric_Pad0.98x0.95mm_HandSolder
R21, R22: 1k; R_0603_1608Metric_Pad0.98x0.95mm_HandSolder
U6: ASEMB-10; Oscillator_SMD_Abracon_ASE-4Pin_3.2x2.5mm_HandSoldering
U7: APM32F405xG; LQFP-100_14x14mm_P0.5mm

Connections:
+3.3V: C11.1, C16.2, C17.1, C18.1, C19.1, C20.1, C21.1, C22.1, C23.1, FB1.1, R22.1, R27.2, U7.6 (VBAT), U7.11 (VDD), U7.19 (VDD), U7.28 (VDD), U7.50 (VDD), U7.75 (VDD), U7.100 (VDD); also elsewhere on the board
BOOT0: R21.2, U7.94 (BOOT0)
CAN1_RXD_MCU: U7.70 (PA11); also elsewhere on the board
CAN1_TXD_MCU: U7.71 (PA12); also elsewhere on the board
Current_A_MCU: U7.30 (PA5); also elsewhere on the board
Current_B_MCU: U7.31 (PA6); also elsewhere on the board
Current_C_MCU: U7.32 (PA7); also elsewhere on the board
DAC_OUT1: U7.29 (PA4)
DC_Voltage_MCU: U7.34 (PC5); also elsewhere on the board
EEPROM_MISO_MCU: U7.79 (PC11); also elsewhere on the board
EEPROM_MOSI_MCU: U7.80 (PC12); also elsewhere on the board
EEPROM_SCK_MCU: U7.78 (PC10); also elsewhere on the board
EEPROM_~CS_MCU: U7.77 (PA15); also elsewhere on the board
GND: C11.2, C16.1, C17.2, C18.2, C19.2, C20.2, C21.2, C22.2, C23.2, C30.2, C31.2, C56.1, C57.2, R20.1, R21.1, U6.2 (GND), U7.10 (VSS), U7.27 (VSS), U7.74 (VSS), U7.99 (VSS); also elsewhere on the board
GNDA: C12.2, C13.2, R20.2, U7.20 (VSSA); also elsewhere on the board
HI_A: U7.40 (PE9); also elsewhere on the board
HI_B: U7.42 (PE11); also elsewhere on the board
HI_C: U7.44 (PE13); also elsewhere on the board
LI_A: U7.39 (PE8); also elsewhere on the board
LI_B: U7.41 (PE10); also elsewhere on the board
LI_C: U7.43 (PE12); also elsewhere on the board
NRST: R22.2, U7.14 (NRST)
NTC_A+: C12.1, C13.1, FB1.2, U7.21 (VREF+), U7.22 (VDDA); also elsewhere on the board
unnamed: C56.2, U6.3 (Out), U7.12 (PH0)
unnamed: C57.1, R26.1, U6.1 (Standby)
unnamed: R27.1, U6.4 (VDD)
unnamed: R26.2, U7.13 (PH1)
unnamed: C30.1, U7.49 (VCAP_1)
unnamed: C31.1, U7.73 (VCAP_2)
OUT_MCU: U7.33 (PC4); also elsewhere on the board
PCB_Temp_A_MCU: U7.25 (PA2); also elsewhere on the board
PCB_Temp_B_MCU: U7.26 (PA3); also elsewhere on the board
PCB_Temp_C_MCU: U7.35 (PB0); also elsewhere on the board
PWM_BKIN: U7.46 (PE15); also elsewhere on the board
SWCLK: U7.76 (PA14); also elsewhere on the board
SWDIO: U7.72 (PA13); also elsewhere on the board
Temp_Coil_A_MCU: U7.23 (PA0); also elsewhere on the board
Temp_Coil_B_MCU: U7.24 (PA1); also elsewhere on the board

Notes on the sheet:
EEPROM_MOSI_MCU
SPI1_MOSI
Angle_OUT
ADC123_IN0
DAC_OUT1
ADC12_IN15
CAN1_RXD_MCU
SPI1_MISO
CAN1_TX
SPI1_NSS/PA4
DC_Voltage_MCU
ADC12_IN5
EEPROM_~{CS_MCU}
ADC123_IN2
Current_C_MCU
CAN1_TXD_MCU
EEPROM_MISO_MCU
PCB_Temp_A_MCU
PCB_Temp_C_MCU
DAC
Temp_Coil_B_MCU
ADC12_IN14
Current_A_MCU
CAN
ADC12_IN6
Temp_Coil_A_MCU
ADC12_IN7
Аналоговый блок
SPI1_SCK
ADC123_IN3
ADC12_IN8
EEPROM_SCK_MCU
SPI
Current_B_MCU
CAN1_RX
PCB_Temp_B_MCU
ADC123_IN1
Интерфейсы
Питание МК

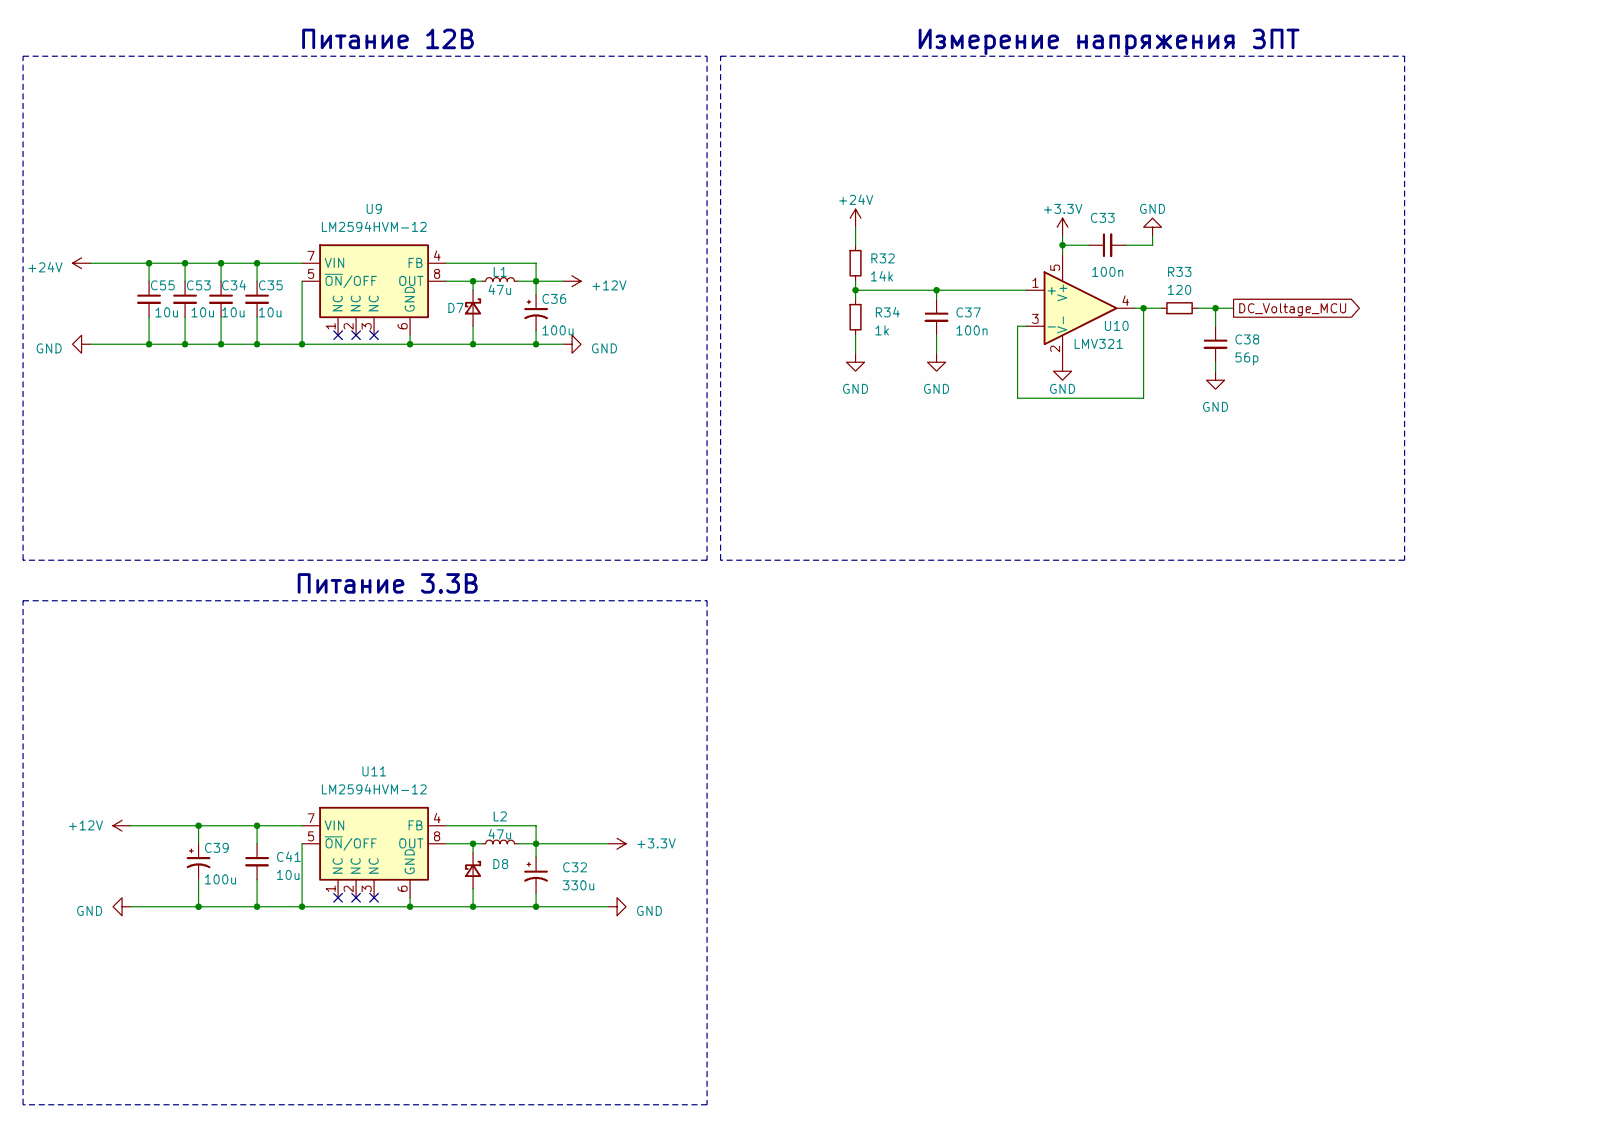
[picture p24: schematic Power_Supply.kicad_sch]

Parts:
C32: 330u; CP_EIA-7343-31_Kemet-D_Pad2.25x2.55mm_HandSolder
C33, C37: 100n; C_0603_1608Metric_Pad1.08x0.95mm_HandSolder
C34, C35, C41, C53, C55: 10u; C_1210_3225Metric_Pad1.33x2.70mm_HandSolder
C36, C39: 100u; CP_EIA-7343-43_Kemet-X_Pad2.25x2.55mm_HandSolder
C38: 56p; C_0603_1608Metric_Pad1.08x0.95mm_HandSolder
D7, D8: MBRA320; D_SMA
L1, L2: 47u; C_2220_5650Metric_Pad1.97x5.40mm_HandSolder
R32: 14k; R_0603_1608Metric_Pad0.98x0.95mm_HandSolder
R33: 120; R_0603_1608Metric_Pad0.98x0.95mm_HandSolder
R34: 1k; R_0603_1608Metric_Pad0.98x0.95mm_HandSolder
U9, U11: LM2594HVM-12; SOIC-8_3.9x4.9mm_P1.27mm
U10: LMV321; SOT-23-5_HandSoldering

Connections:
+3.3V: C32.1, C33.1, L2.2, U10.5 (V+), U11.4 (FB); also elsewhere on the board
+12V: C36.1, C39.1, C41.1, L1.2, U9.4 (FB), U11.7 (VIN); also elsewhere on the board
+24V: C34.1, C35.1, C53.1, C55.1, R32.1, U9.7 (VIN); also elsewhere on the board
DC_Voltage_MCU: C38.1, R33.2; also elsewhere on the board
GND: C32.2, C33.2, C34.2, C35.2, C36.2, C37.2, C38.2, C39.2, C41.2, C53.2, C55.2, D7.2 (A), D8.2 (A), R34.2, U9.5 (~ON/OFF), U9.6 (GND), U10.2 (V-), U11.5 (~ON/OFF), U11.6 (GND); also elsewhere on the board
unnamed: D7.1 (K), L1.1, U9.8 (OUT)
unnamed: D8.1 (K), L2.1, U11.8 (OUT)
unnamed: C37.1, R32.2, R34.1, U10.1 (+)
unnamed: R33.1, U10.3 (-), U10.4

Notes on the sheet:
Питание 3.3В
Измерение напряжения ЗПТ
Питание 12В

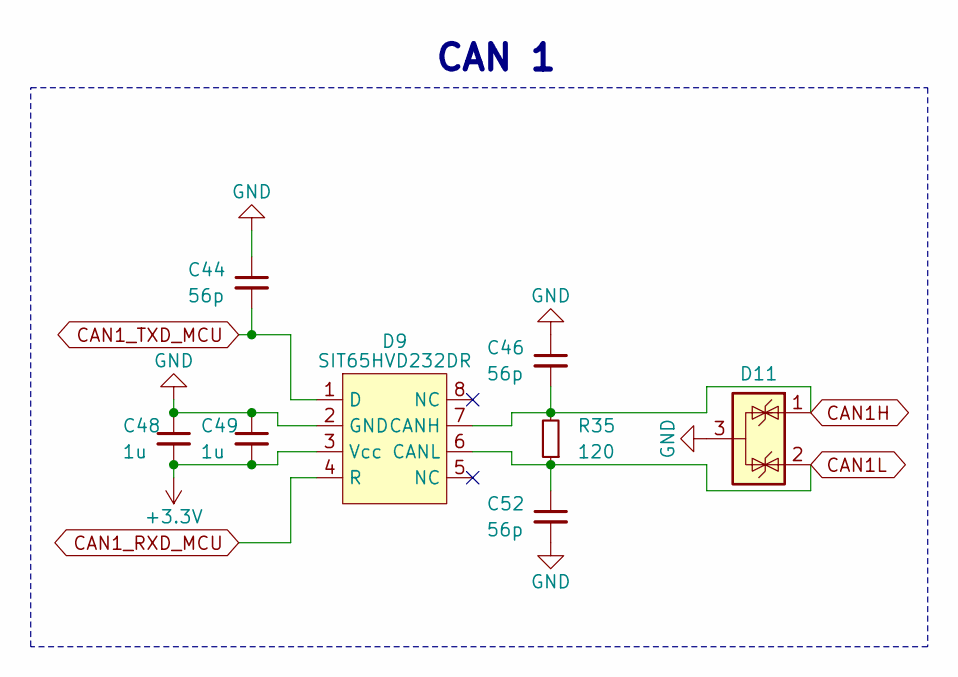
[picture p25: schematic CAN.kicad_sch]

Parts:
C44, C46, C52: 56p; C_0603_1608Metric_Pad1.08x0.95mm_HandSolder
C48, C49: 1u; C_0603_1608Metric_Pad1.08x0.95mm_HandSolder
D9: SIT65HVD232DR; SOIC-8_3.9x4.9mm_P1.27mm
D11: PESD2CAN; SOT-23
R35: 120; R_0603_1608Metric_Pad0.98x0.95mm_HandSolder

Connections:
+3.3V: C48.2, C49.2, D9.3 (Vcc); also elsewhere on the board
CAN1H: C46.2, D9.7 (CANH), D11.1 (K), R35.2; also elsewhere on the board
CAN1L: C52.1, D9.6 (CANL), D11.2 (K), R35.1; also elsewhere on the board
CAN1_RXD_MCU: D9.4 (R); also elsewhere on the board
CAN1_TXD_MCU: C44.2, D9.1 (D); also elsewhere on the board
GND: C44.1, C46.1, C48.1, C49.1, C52.2, D9.2 (GND), D11.3 (A); also elsewhere on the board

Notes on the sheet:
CAN 1

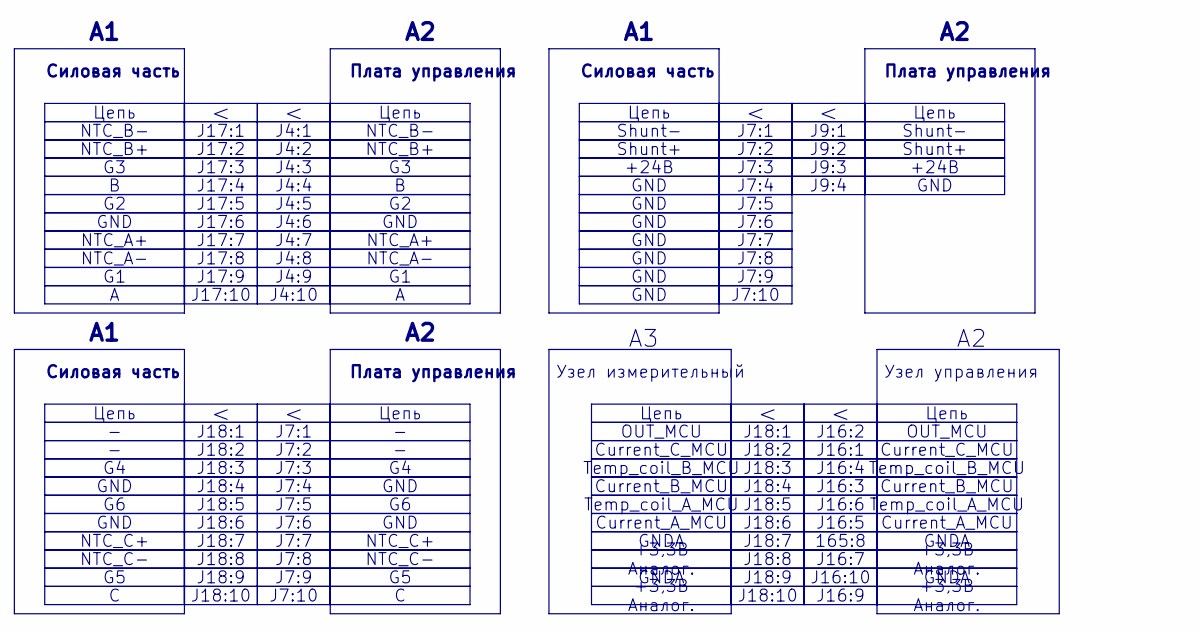
[picture p26: schematic Connection_list.kicad_sch]

Notes on the sheet:
GND
J16:4
GNDA
J7:10
J18:2
J7:6
J7:6
J18:8
Temp_coil_B_MCU
J7:4
Shunt+
J18:7
J17:8
J4:6
NTC_C+
J7:3
Цепь
J7:1
J16:7
+24В
J18:10
J7:9
J18:3
J7:7
OUT_MCU
J7:3
J18:8
NTC_B-
J18:4
J7:7
J18:6
NTC_A+
J9:3
Shunt-
+3,3В Аналог.
J4:10
Temp_coil_A_MCU
J18:3
J18:1
J7:2
Current_B_MCU
J16:2
J7:5
165:8
J7:8
Current_C_MCU
NTC_B+
J9:1
J17:2
J17:6
J4:4
J18:6
J17:10
J18:5
J16:6
J16:10
J9:2
J17:4
J18:9
J16:1
J17:1
J16:9
J16:5
NTC_A-
J4:1
J18:5
J17:7
J18:9
J17:3
J4:2
Current_A_MCU
J7:2
J4:5
J16:3
J17:5
J4:9
J4:7
J4:8
NTC_C-
J17:9
J18:2
J4:3
J9:4
Плата управления
Силовая часть
Узел управления
Узел измерительный

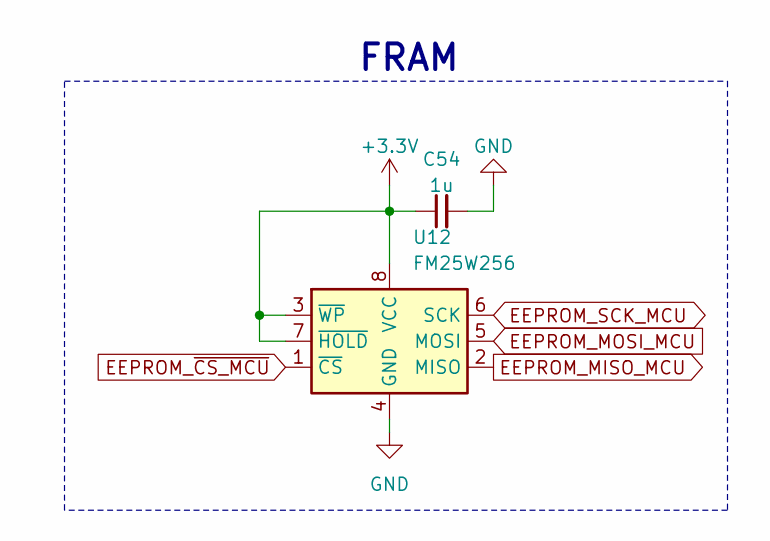
[picture p27: schematic EEPROM.kicad_sch]

Parts:
C54: 1u; C_0603_1608Metric_Pad1.08x0.95mm_HandSolder
U12: FM25W256; SOIC-8_3.9x4.9mm_P1.27mm

Connections:
+3.3V: C54.1, U12.3 (~WP), U12.7 (~HOLD), U12.8 (VCC); also elsewhere on the board
EEPROM_MISO_MCU: U12.2 (MISO); also elsewhere on the board
EEPROM_MOSI_MCU: U12.5 (MOSI); also elsewhere on the board
EEPROM_SCK_MCU: U12.6 (SCK); also elsewhere on the board
EEPROM_~CS_MCU: U12.1 (~CS); also elsewhere on the board
GND: C54.2, U12.4 (GND); also elsewhere on the board

Notes on the sheet:
FRAM

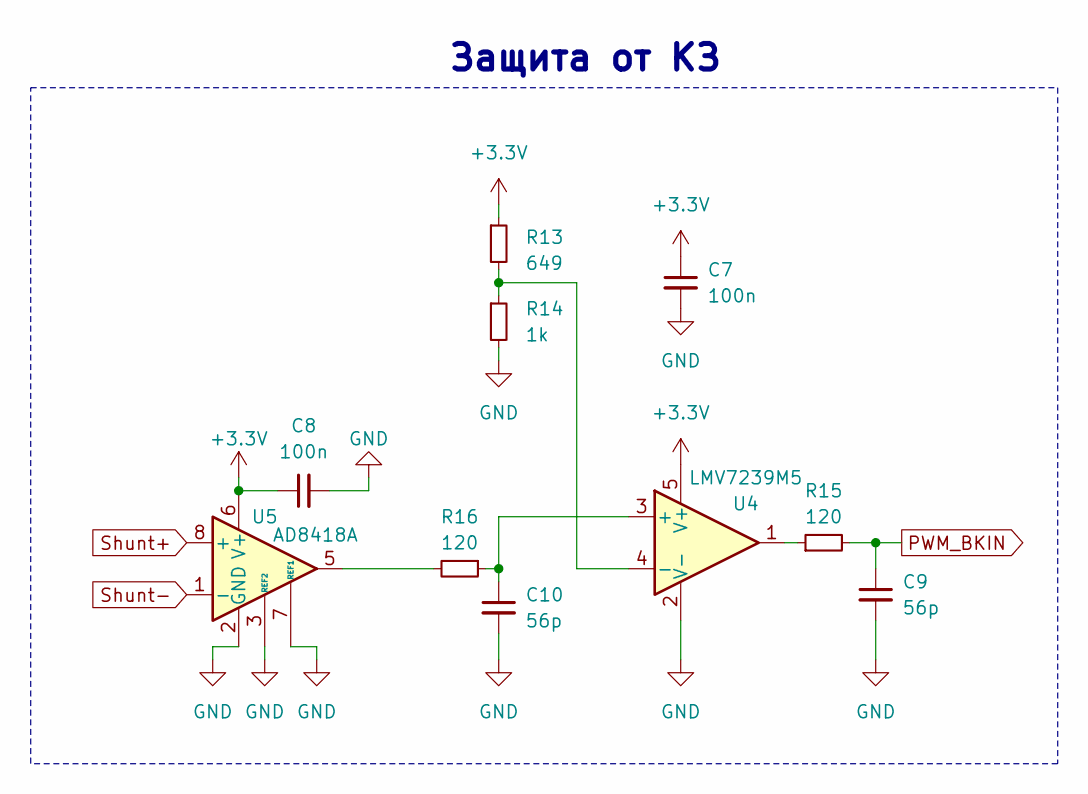
[picture p28: schematic Overcurrent_Protection.kicad_sch]

Parts:
C7, C8: 100n; C_0603_1608Metric_Pad1.08x0.95mm_HandSolder
C9, C10: 56p; C_0603_1608Metric_Pad1.08x0.95mm_HandSolder
R13: 649; R_0603_1608Metric_Pad0.98x0.95mm_HandSolder
R14: 1k; R_0603_1608Metric_Pad0.98x0.95mm_HandSolder
R15, R16: 120; R_0603_1608Metric_Pad0.98x0.95mm_HandSolder
U4: LMV7239M5; SOT-23-5_HandSoldering
U5: AD8418A; SOIC-8_3.9x4.9mm_P1.27mm

Connections:
+3.3V: C7.1, C8.1, R13.1, U4.5 (V+), U5.6 (V+); also elsewhere on the board
GND: C7.2, C8.2, C9.2, C10.2, R14.2, U4.2 (V-), U5.2 (GND), U5.3 (REF2), U5.7 (REF1); also elsewhere on the board
unnamed: R15.1, U4.1
unnamed: R16.2, U5.5
unnamed: C10.1, R16.1, U4.3 (+)
unnamed: R13.2, R14.1, U4.4 (-)
PWM_BKIN: C9.1, R15.2; also elsewhere on the board
Shunt+: U5.8 (+); also elsewhere on the board
Shunt-: U5.1 (-); also elsewhere on the board

Notes on the sheet:
Защита от КЗ

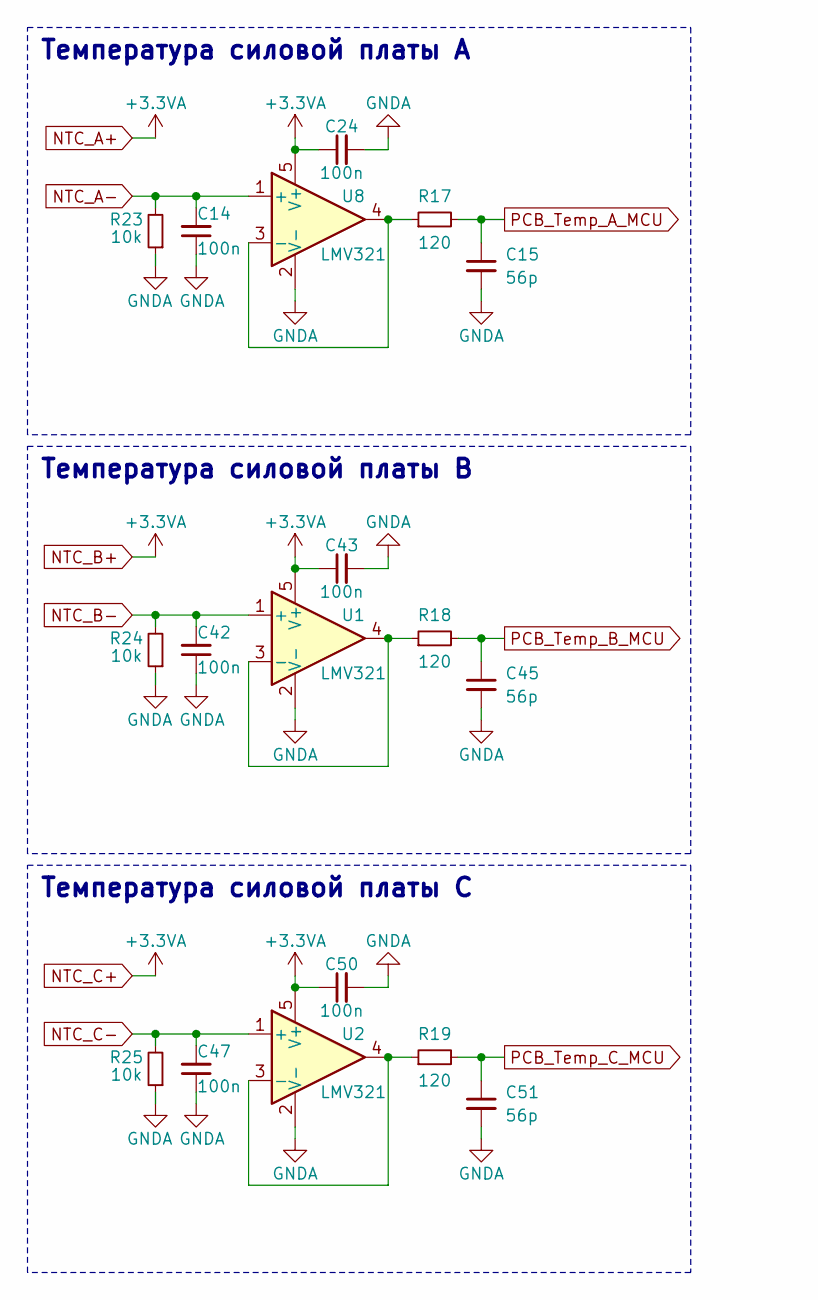
[picture p29: schematic Temperture_measure.kicad_sch]

Parts:
C14, C24, C42, C43, C47, C50: 100n; C_0603_1608Metric_Pad1.08x0.95mm_HandSolder
C15, C45, C51: 56p; C_0603_1608Metric_Pad1.08x0.95mm_HandSolder
R17, R18, R19: 120; R_0603_1608Metric_Pad0.98x0.95mm_HandSolder
R23, R24, R25: 10k; R_0603_1608Metric_Pad0.98x0.95mm_HandSolder
U1, U2, U8: LMV321; SOT-23-5_HandSoldering

Connections:
GNDA: C14.1, C15.2, C24.2, C42.1, C43.2, C45.2, C47.1, C50.2, C51.2, R23.1, R24.1, R25.1, U1.2 (V-), U2.2 (V-), U8.2 (V-); also elsewhere on the board
NTC_A+: C24.1, C43.1, C50.1, U1.5 (V+), U2.5 (V+), U8.5 (V+); also elsewhere on the board
NTC_A-: C14.2, R23.2, U8.1 (+); also elsewhere on the board
NTC_B-: C42.2, R24.2, U1.1 (+); also elsewhere on the board
NTC_C-: C47.2, R25.2, U2.1 (+); also elsewhere on the board
unnamed: R18.1, U1.3 (-), U1.4
unnamed: R19.1, U2.3 (-), U2.4
unnamed: R17.1, U8.3 (-), U8.4
PCB_Temp_A_MCU: C15.1, R17.2; also elsewhere on the board
PCB_Temp_B_MCU: C45.1, R18.2; also elsewhere on the board
PCB_Temp_C_MCU: C51.1, R19.2; also elsewhere on the board

Notes on the sheet:
Температура силовой платы A
Температура силовой платы B
Температура силовой платы C

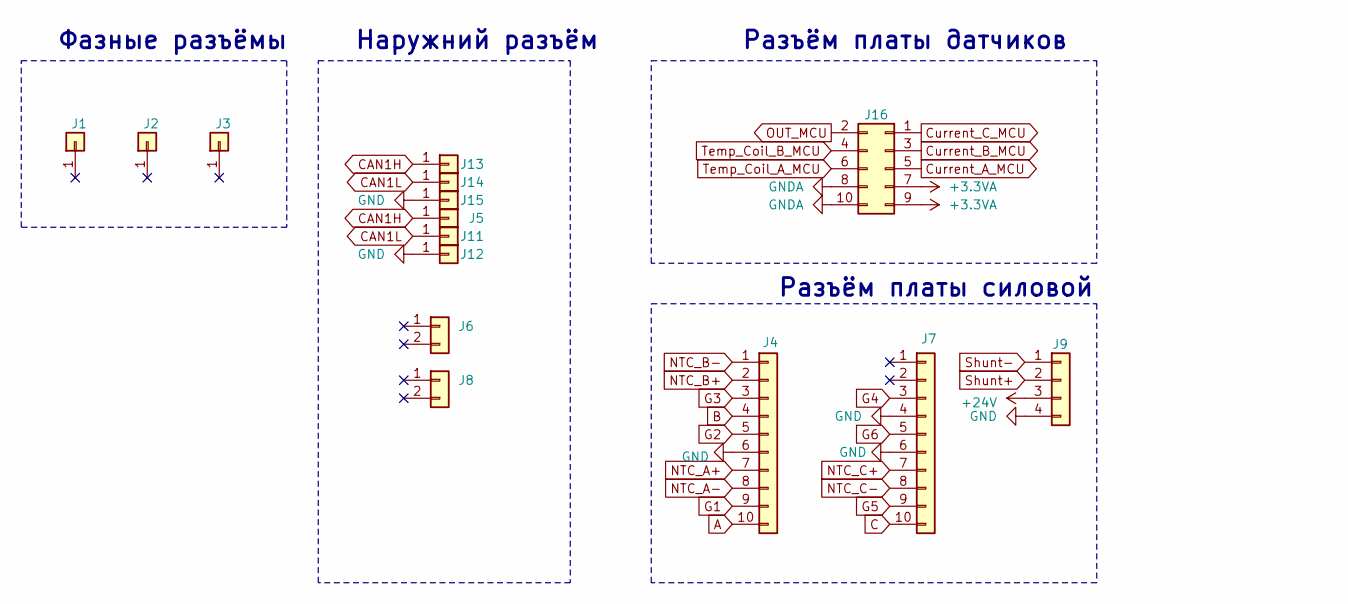
[picture p30: schematic Connectors.kicad_sch]

Parts:
J1: A; Hole_9mm
J2: B; Hole_9mm
J3: C; Hole_9mm
J4, J7: Conn_01x10; PinHeader_1x10_P1.27mm_Vertical
J5, J11, J12, J13, J14, J15: C; Wire_one
J6, J8: Conn_01x02; PinHeader_1x02_P1.27mm_Vertical
J9: Conn_01x04; PinHeader_1x04_P1.27mm_Vertical
J16: Conn_02x05_Odd_Even; PinHeader_2x05_P1.27mm_Vertical

Connections:
+24V: J9.3; also elsewhere on the board
A: J4.10; also elsewhere on the board
B: J4.4; also elsewhere on the board
C: J7.10; also elsewhere on the board
CAN1H: J5.1, J13.1; also elsewhere on the board
CAN1L: J11.1, J14.1; also elsewhere on the board
Current_A_MCU: J16.5; also elsewhere on the board
Current_B_MCU: J16.3; also elsewhere on the board
Current_C_MCU: J16.1; also elsewhere on the board
G1: J4.9; also elsewhere on the board
G2: J4.5; also elsewhere on the board
G3: J4.3; also elsewhere on the board
G4: J7.3; also elsewhere on the board
G5: J7.9; also elsewhere on the board
G6: J7.5; also elsewhere on the board
GND: J4.6, J7.4, J7.6, J9.4, J12.1, J15.1; also elsewhere on the board
GNDA: J16.8, J16.10; also elsewhere on the board
NTC_A+: J4.2, J4.7, J7.7, J16.7, J16.9; also elsewhere on the board
NTC_A-: J4.8; also elsewhere on the board
NTC_B-: J4.1; also elsewhere on the board
NTC_C-: J7.8; also elsewhere on the board
OUT_MCU: J16.2; also elsewhere on the board
Shunt+: J9.2; also elsewhere on the board
Shunt-: J9.1; also elsewhere on the board
Temp_Coil_A_MCU: J16.6; also elsewhere on the board
Temp_Coil_B_MCU: J16.4; also elsewhere on the board

Notes on the sheet:
Фазные разъёмы
Разъём платы датчиков
Наружний разъём
Разъём платы силовой

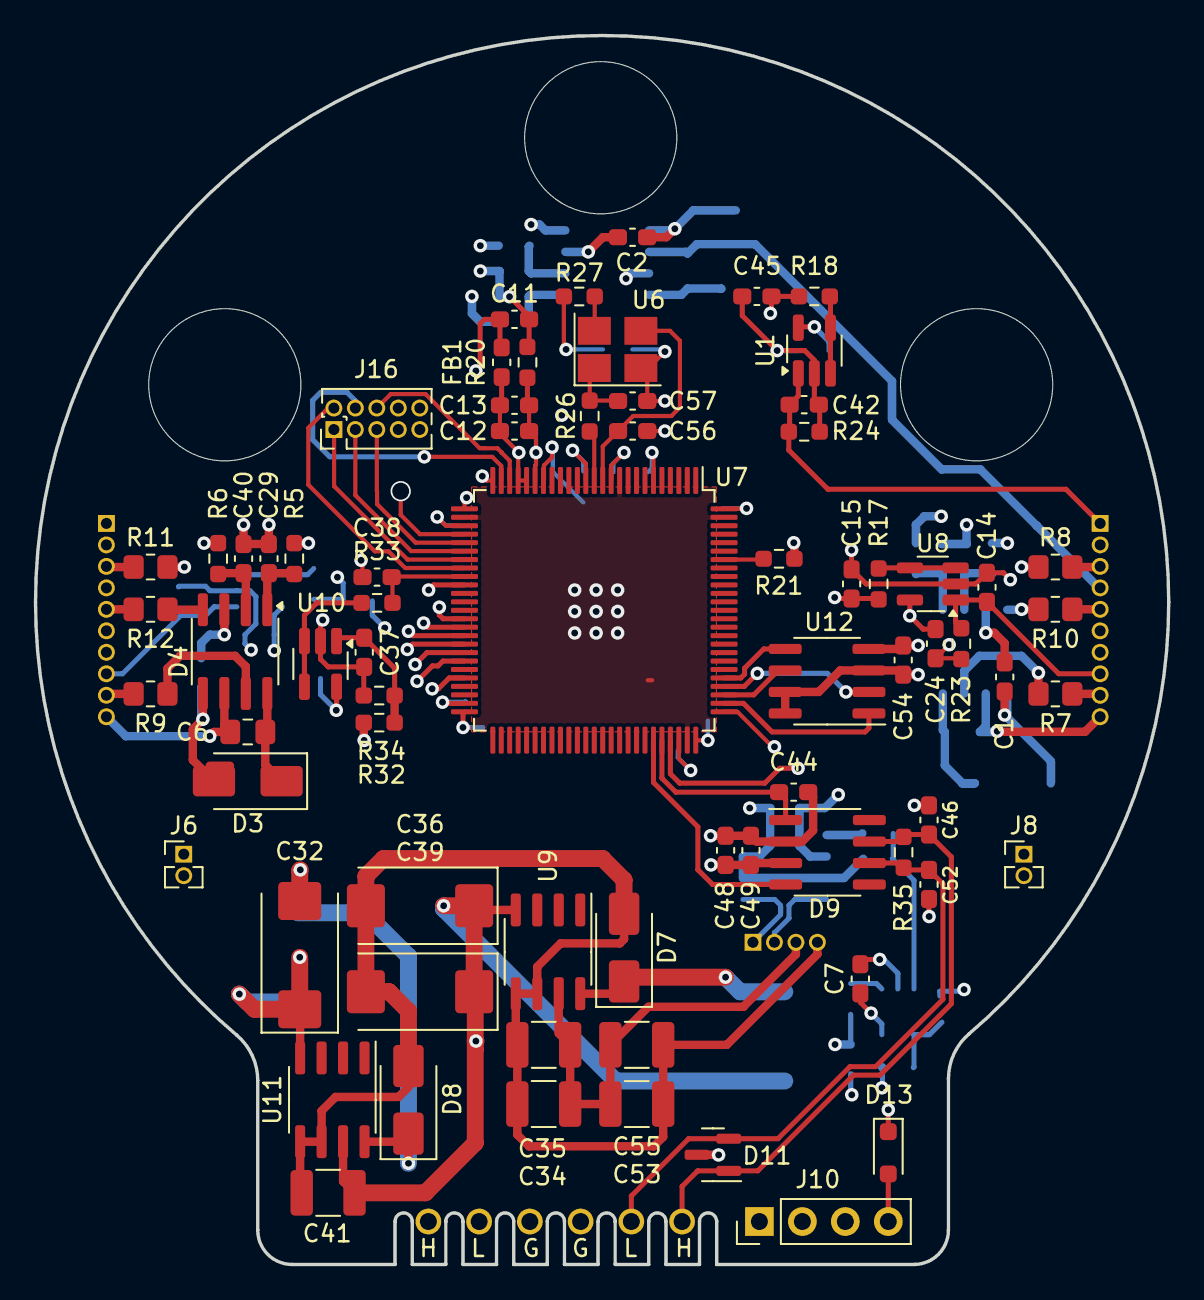
[picture p31: board Плата управления.kicad_pcb from above]

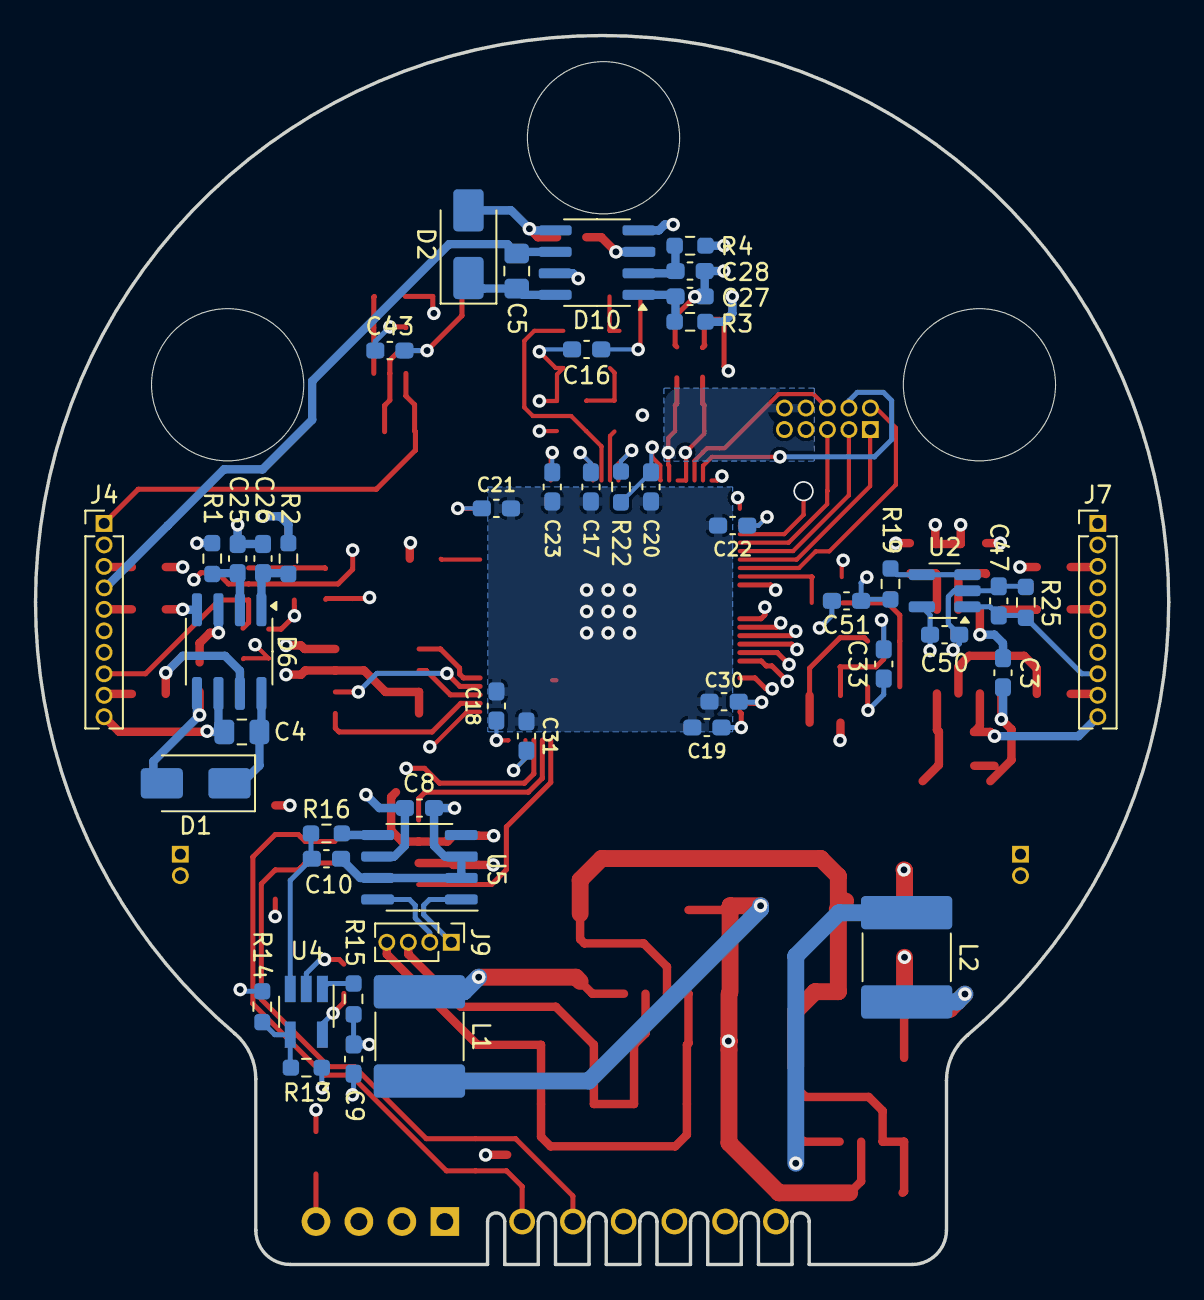
[picture p32: board Плата управления.kicad_pcb from below]

Board: 6 copper layers, 67.0 x 72.7 mm, 129 parts (48 on the bottom side), 82 nets.
