Alexandr-Filatov/KAMAZ_MCU_PCB/(commit log)

2023-11-16 Нулевой вариант
    [CAN.kicad_sch, Connectors.kicad_sch, Driver.kicad_sch, MCU.kicad_sch, Overcurrent_Measure_and_Protection.kicad_sch, Overcurrent_Protection.kicad_sch, Power_Supply.kicad_sch, Rotary_Position_Sensor.kicad_sch]
2023-11-16 Питание с (lib_symbols
    [Плата управления.kicad_pcb]
2023-11-16 Питанипе с TPS55165QPWPRQ1
    [Плата управления.kicad_pcb]
2023-11-18 Поенял усилитель измерительный AD8210 на automotive исполнение INA283AID
    [Overcurrent_Measure_and_Protection.kicad_sch, Power_Supply.kicad_sch, Плата управления.kicad_pcb]
2023-11-18 Заменил датчик положения ротора на NSM3012
    [Overcurrent_Measure_and_Protection.kicad_sch, Rotary_Position_Sensor.kicad_sch]
2023-11-18 Добавил 3.3В CAN SN65HVD232
    [CAN.kicad_sch, Rotary_Position_Sensor.kicad_sch]
2023-11-18 Добавил питание 12В в automotive испорлнении и 3.3В
    [IHLP2525.step, LQH66SN103M03K.stp, Power_Supply.kicad_sch, TPSM365R6FRDNR.stp, Плата управления.kicad_pcb, Плата управления.kicad_sch]
2023-11-19 Добавил питание MCU и кварц на 8Мгц
    [MCU.kicad_sch, Overcurrent_Measure_and_Protection.kicad_sch, Overcurrent_Protection.kicad_sch, Power_Supply.kicad_sch, Плата управления.kicad_pcb, Плата управления.kicad_sch]
2023-11-19 Привел в порядок схему
    [CAN.kicad_sch, Connectors.kicad_sch, Driver.kicad_sch, MCU.kicad_sch, Overcurrent_Protection.kicad_sch, Power_Supply.kicad_sch, Rotary_Position_Sensor.kicad_sch, Temperture_measure.kicad_sch]
2023-11-19 Расставил драйвера
    [Connectors.kicad_sch, MCU.kicad_sch, Overcurrent_Protection.kicad_sch, Плата управления.kicad_pcb]
2023-11-21 Добавил EEPROM
    [Connectors.kicad_sch, EEPROM.kicad_sch, FLASH_Memory.kicad_sch, MCU.kicad_sch, RS485.kicad_sch, Плата управления.kicad_pcb, Плата управления.kicad_sch]
2023-11-22 Расставил компоненты по плате
    [Connectors.kicad_sch, JTAG.kicad_sch, Power_Supply.kicad_sch, Temperture_measure.kicad_sch, Плата управления.kicad_pcb, Плата управления.kicad_sch]
2023-11-26 Изменил контур под новую крышку
    [CAN.kicad_sch, Connectors.kicad_sch, Плата управления.kicad_pcb]
2023-11-29 Добавил разъёмы под интерфейсы
    [532610271.STEP, 532610371.STEP, 532610471.STEP, 532610571.STEP, 532610671.STEP, 532610771.STEP, 532610871.STEP, 532610971.STEP]
2023-12-01 Новый контур платы
    [CAN.kicad_sch, Connectors.kicad_sch, MCU.kicad_sch, Temperture_measure.kicad_sch, Плата управления.kicad_pcb]
2023-12-03 Заменил разъём под силовую плату
    [530480610.stp, CAN.kicad_sch, Connectors.kicad_sch, EEPROM.kicad_sch, MCU.kicad_sch, Power_Supply.kicad_sch, Temperture_measure.kicad_sch, Плата управления.kicad_pcb]
2023-12-05 Изменил межплатный разъем
    [Connectors.kicad_sch, Плата управления.kicad_pcb]
2023-12-05 Разделил аналоговое и цифровое питание
    [530481010.stp, Connectors.kicad_sch, MCU.kicad_sch, Temperture_measure.kicad_sch, Плата управления.kicad_pcb]
2023-12-11 Редактировал схему
    [CAN.kicad_sch, Connectors.kicad_sch, EEPROM.kicad_sch, MCU.kicad_sch, Overcurrent_Protection.kicad_sch, Power_Supply.kicad_sch, RS485.kicad_sch, Temperture_measure.kicad_sch]
2023-12-12 Финальная доработка
2023-12-12 Ещё нужно доработать
    [Connectors.kicad_sch, Driver.kicad_sch, MCU.kicad_sch, Overcurrent_Protection.kicad_sch, Power_Supply.kicad_sch, Плата управления.kicad_pcb]
2023-12-15 Собираю документацию
    [CAN.kicad_sch, EEPROM.kicad_sch, MCU.kicad_sch, Power_Supply.kicad_sch, RS485.kicad_sch, SWD.kicad_sch, Плата управления.kicad_pcb, Плата управления.kicad_sch]
2023-12-17 Добавил документы
    [CAN.kicad_sch, Connectors.kicad_sch, Driver.kicad_sch, EEPROM.kicad_sch, MCU.kicad_sch, Overcurrent_Protection.kicad_sch, RS485.kicad_sch, SWD.kicad_sch]
2023-12-17 Добавил все документы
    [CAN.kicad_sch, Connectors.kicad_sch, Driver.kicad_sch, EEPROM.kicad_sch, MCU.kicad_sch, Overcurrent_Protection.kicad_sch, Power_Supply.kicad_sch, RS485.kicad_sch]
2023-12-24 Версия под отчёт
    [CAN.kicad_sch, Connection_list.kicad_sch, Connectors.kicad_sch, Driver.kicad_sch, EEPROM.kicad_sch, MCU.kicad_sch, Overcurrent_Protection.kicad_sch, Power_Supply.kicad_sch]
2024-08-12 Добавил NTC обработку
    [CAN.kicad_sch, Connection_list.kicad_sch, Connectors.kicad_sch, Driver.kicad_sch, EEPROM.kicad_sch, MCU.kicad_sch, Overcurrent_Protection.kicad_sch, Power_Supply.kicad_sch]
2024-09-25 Новые драйвера и разъёмы
    [Connectors.kicad_sch, Driver.kicad_sch, MCU.kicad_sch, Overcurrent_Protection.kicad_sch, Power_Supply.kicad_sch, Temperture_measure.kicad_sch, Плата управления.kicad_pcb]
2024-09-26 Развел все длорожки
    [MCU.kicad_sch, Overcurrent_Protection.kicad_sch, Плата управления.kicad_pcb]
2024-09-29 Добавил разъёмф для крепления
    [Connectors.kicad_sch, MCU.kicad_sch, Плата управления.kicad_pcb]
2024-09-30 Добавил модель плты
    [Connectors.kicad_sch, MCU.kicad_sch, Плата управления.kicad_pcb, Плата управления.step, Плата управления_1.step]
2024-10-01 Добавил все в BOM
    [Connectors.kicad_sch, Driver.kicad_sch, MCU.kicad_sch, Overcurrent_Protection.kicad_sch, Power_Supply.kicad_sch, Плата управления.kicad_pcb]
2024-10-01 Примерил разъёмы межплатные
2024-10-02 Добавил съемные разъемы
    [Connectors.kicad_sch, Плата управления.kicad_pcb]
2024-10-03 Отправил на проверку в резонит
    [Плата управления-B_Cu.gbr, Плата управления-B_Mask.gbr, Плата управления-B_Paste.gbr, Плата управления-B_Silkscreen.gbr, Плата управления-Edge_Cuts.gbr, Плата управления-F_Cu.gbr, Плата управления-F_Mask.gbr, Плата управления-F_Paste.gbr]
2024-12-02 Изменения: добавил папку с отчетностью
    [CAN.kicad_sch, Connection_list.kicad_sch, Connectors.kicad_sch, Driver.kicad_sch, EEPROM.kicad_sch, MCU.kicad_sch, Overcurrent_Protection.kicad_sch, Power_Supply.kicad_sch]
